waagbo/picogus-tht/hw-tht-v1.3/docs/figures/groundloop.png

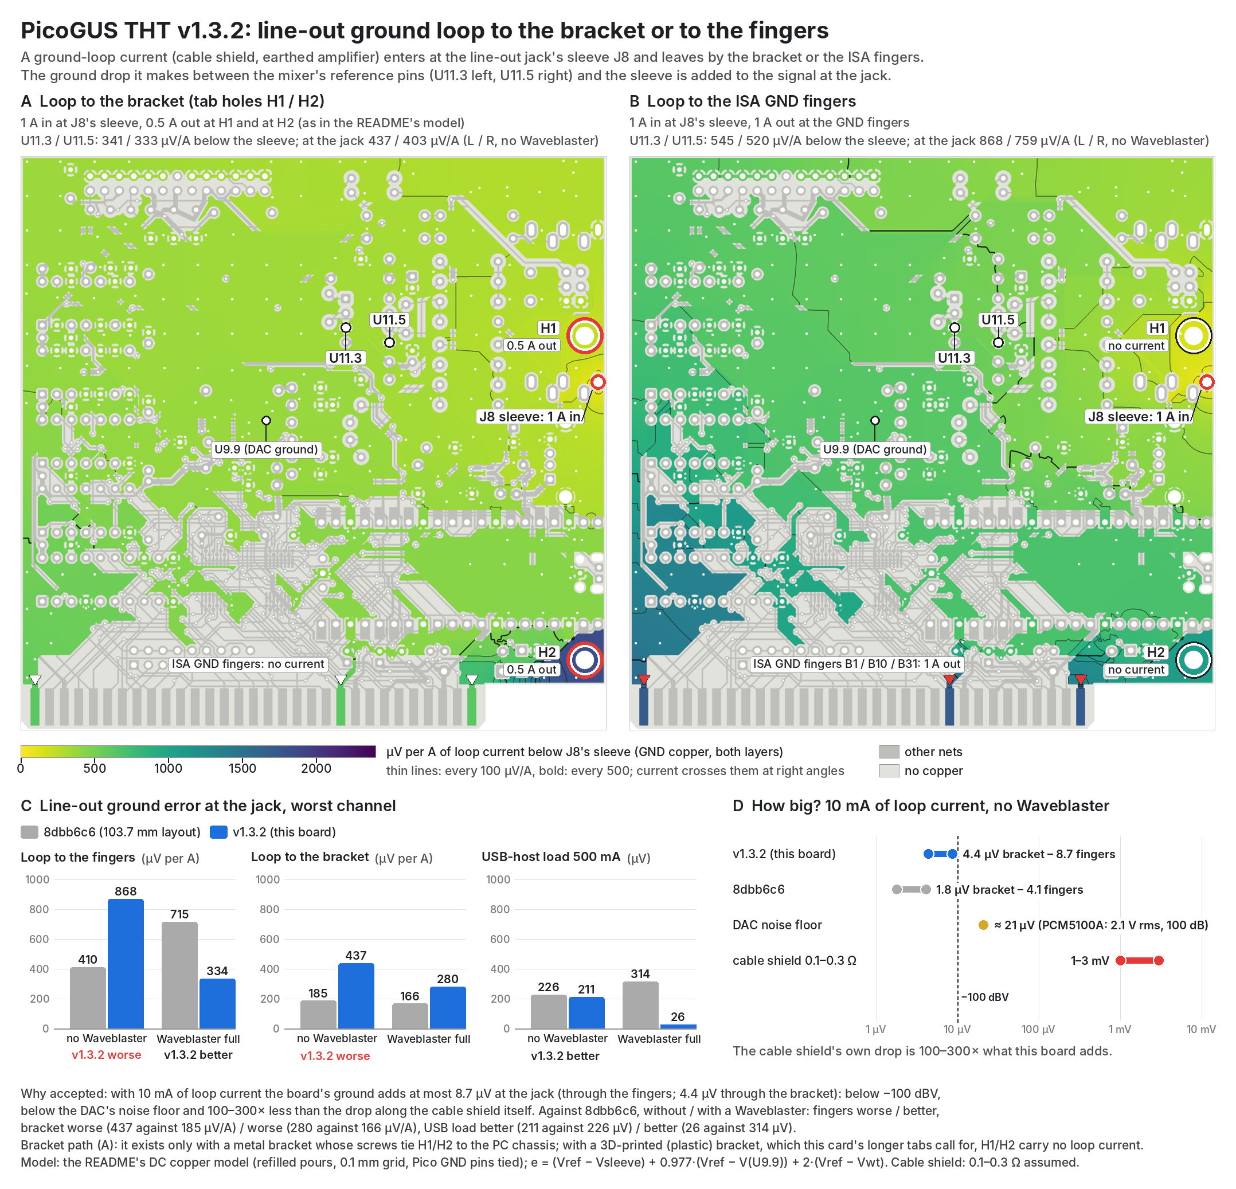
hw-tht-v1.3/docs/figures/groundloop.png
