waagbo/picogus-tht/hw-tht-v1.3/docs/figures/i2s-around-dac.png

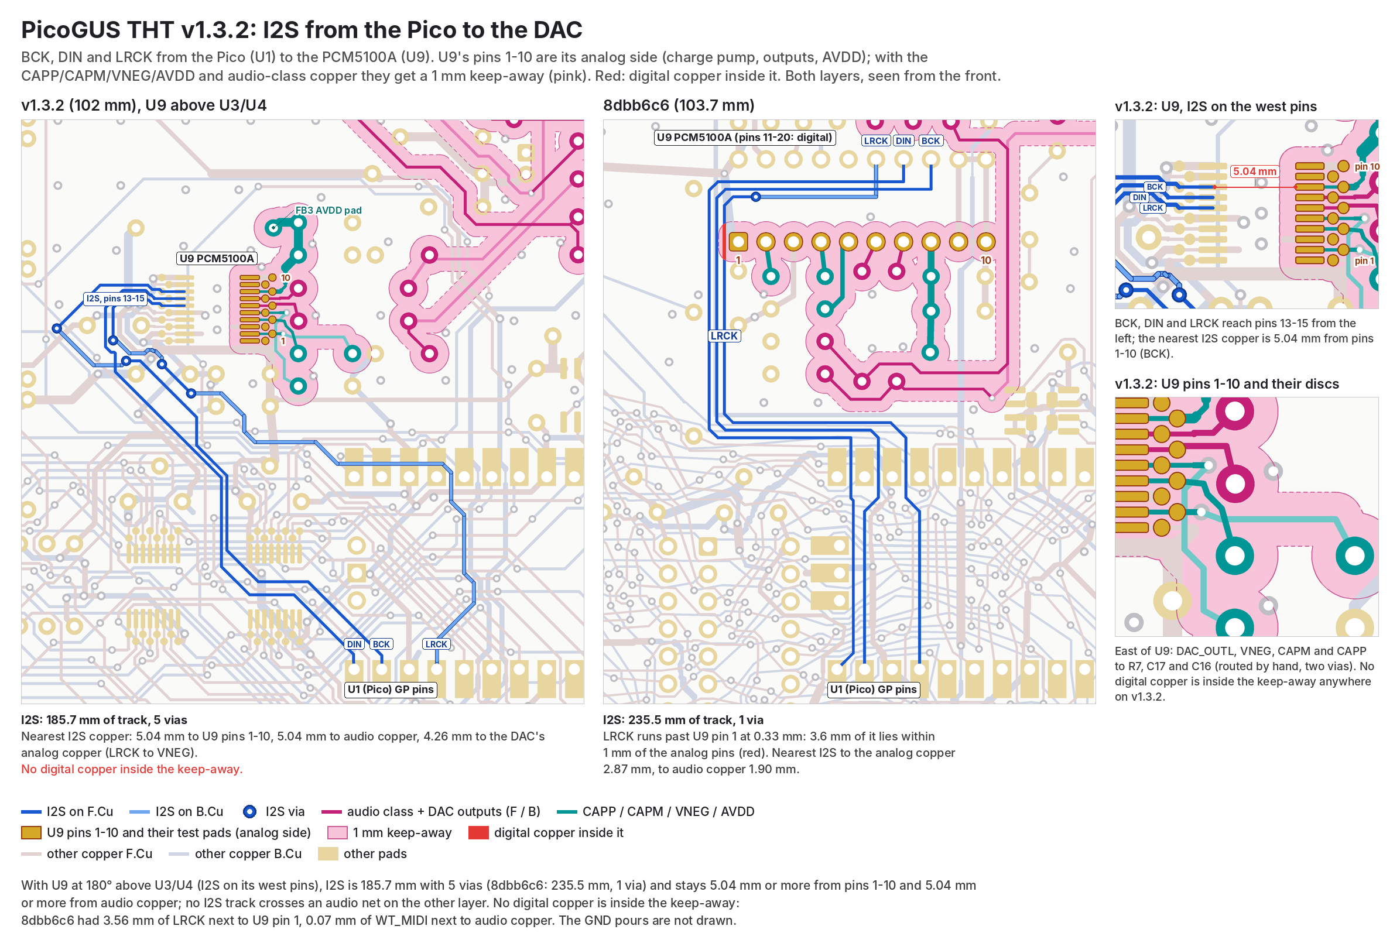
hw-tht-v1.3/docs/figures/i2s-around-dac.png
