waagbo/picogus-tht/hw-tht-v1.3/docs/figures/placement-options.png

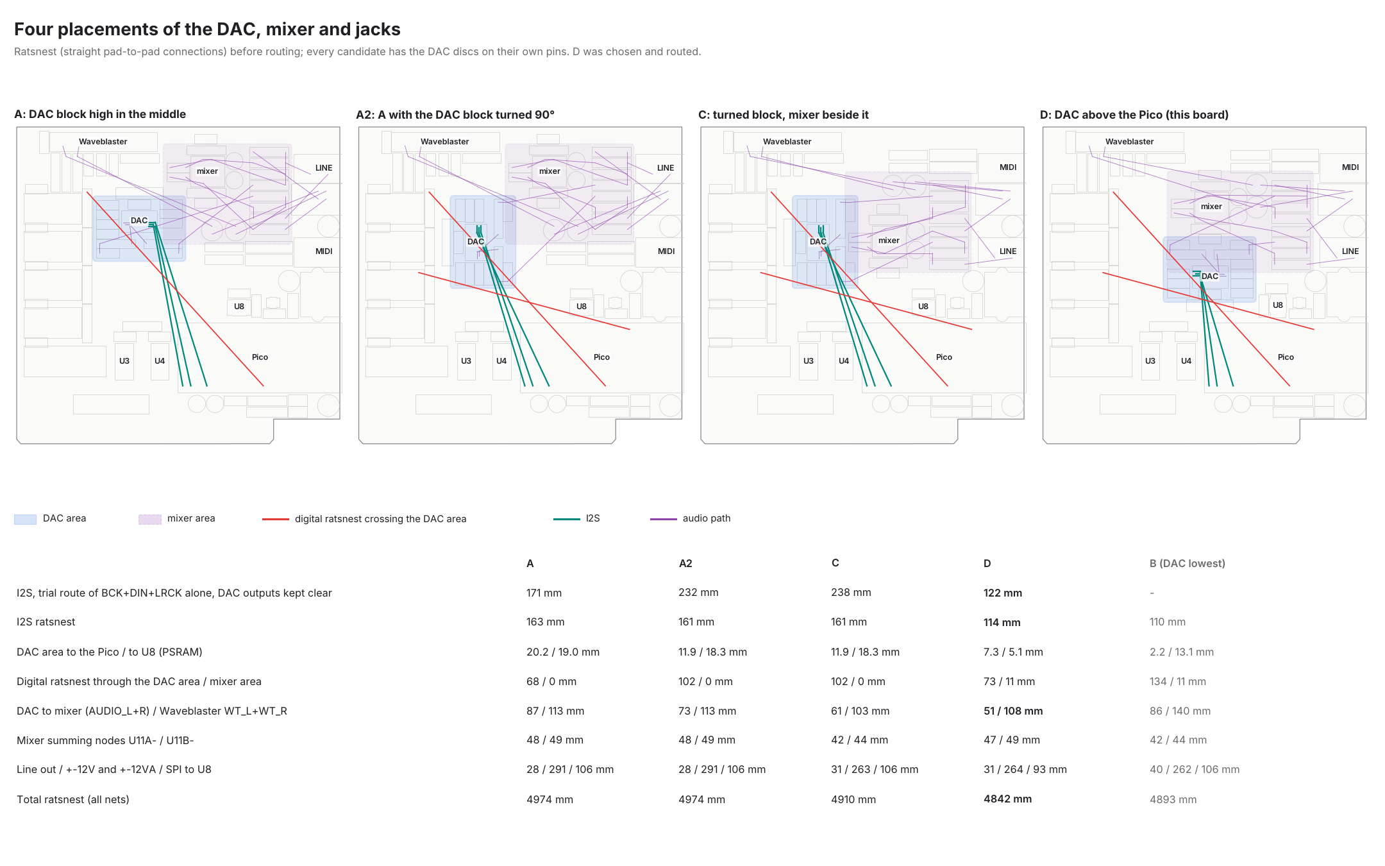
hw-tht-v1.3/docs/figures/placement-options.png
