waagbo/picogus-tht/hw-tht-v1.3/docs/renders/PicoGUS-THT-v1.3.2-red-back.jpg

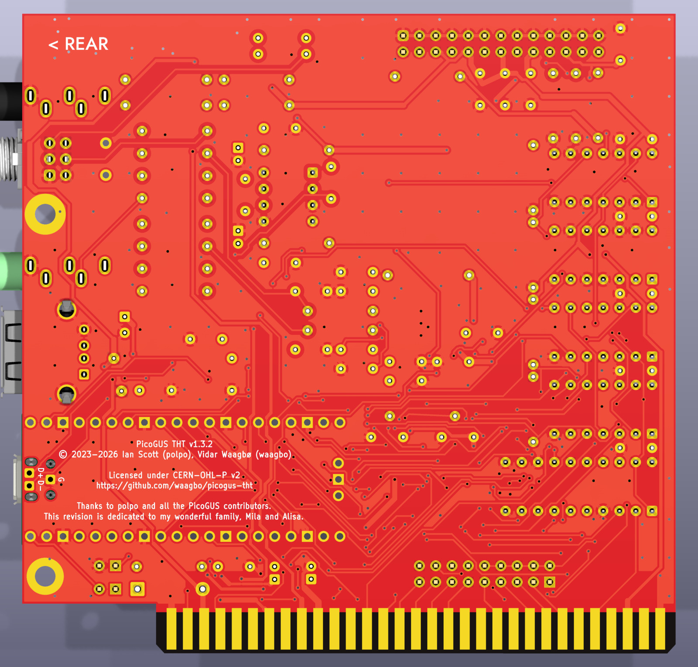
hw-tht-v1.3/docs/renders/PicoGUS-THT-v1.3.2-red-back.jpg
