waagbo/picogus-tht/hw-tht-v1.3/docs/BOM-THT-mouser.csv

Quantity | Manufacturer Part Number | Manufacturer | Customer Part Number | Description
1 | SC0915 | Raspberry Pi | U1 | Raspberry Pi Pico
1 | SN74AHC244N | Texas Instruments | U2 | 74AHC244
2 | SN74CB3T3257PWR | Texas Instruments | U3,U4 | SN74CB3T3257
1 | SN74AHC14N | Texas Instruments | U5 | 74AHC14
2 | SN74AHC00N | Texas Instruments | U6,U7 | 74AHC00
1 | APS6404L-3SQR-SN | AP Memory | U8 | APS6404L-3SQR-SN
1 | PCM5100APWR | Texas Instruments | U9 | PCM5100A
1 | SN74AHCT126N | Texas Instruments | U10 | 74AHCT126
1 | 1N5819RLG | onsemi | D1 | 1N5819
2 | RNMF14FTC220R | Stackpole | R3,R4 | 220R
2 | RNMF14FTC470R | Stackpole | R7,R8 | 470R
1 | MFR-25FBF52-1K | Yageo | R1 | 1k
5 | MFR-25FBF52-10K | Yageo | R9,R12,R13,R16,R17 | 10k
4 | MFR-25FBF52-20K | Yageo | R10,R11,R19,R20 | 20k
3 | MFR-25FBF52-15K | Yageo | R2,R5,R6 | 15k
20 | RDER71H104K0M1H03A | Murata | 0.1uF x20 | 0.1uF
1 | RDER71H105K2M1H03A | Murata | C10 | 1uF
2 | FG24X7R1H225KRT06 | TDK | C16,C17 | 2.2uF
2 | RCER71H106MWK1H03B | Murata | C15,C24 | 10uF
2 | FG28C0G1H222JNT06 | TDK | C19,C20 | 2.2nF C0G
4 | 35YXJ47M5X11 | Rubycon | C1,C2,C32,C33 | 47uF
2 | ECE-A1HN100U | Panasonic | C22,C23 | 10uF bipolar
3 | 2743002112 | Fair-Rite | FB1,FB2,FB3 | Ferrite bead
1 | PTD902-2015F-A103 | Bourns | RV1 | 10k dual log
1 | 77313-118-18LF | Amphenol ICC (FCI) | J1 | 2x9 header, gold
4 | M7582-05 | Harwin | J1,J7 shunts | 2.54mm jumper shunt
2 | 77311-118-02LF | Amphenol ICC (FCI) | J6,J7 | 1x2 header, gold
1 | SJ1-3535NG | Same Sky (CUI) | J5 | SJ1-3535NG (black)
1 | SJ1-3535NG-GR | Same Sky (CUI) | J8 | SJ1-3535NG-GR (green)
1 | 77313-118-26LF | Amphenol ICC (FCI) | J9 | Waveblaster 2x13 male, gold
1 | 0676430910 | Molex | J11 | USB-A receptacle
1 | MF-R050 | Bourns | F1 | 0.5A PTC
1 | 16ZLH220MEFC6.3X11 | Rubycon | C34 | 220uF
1 | NE5532P | Texas Instruments | U11 | NE5532
3 | MFR-25FBF52-100K | Yageo | R14,R15,R18 | 100k
2 | MFR-25FBF52-10R | Yageo | R23,R24 | 10R
2 | MFR-25FBF52-100R | Yageo | R21,R22 | 100R
2 | K470J15C0GF5TH5 | Vishay | C30,C31 | 47pF C0G
2 | PPTC201LFBN-RC | Sullins | U1 sockets (optional) | 1x20 female header x2
4 | ICM-314-1-GT-HT | Adam Tech | U5,U6,U7,U10 (opt.) | DIP-14 socket
1 | SA203000 | On Shore Technology | U2 socket (optional) | DIP-20 socket
1 | SA083000 | On Shore Technology | U11 socket (optional) | DIP-8 socket
1 | USBLC6-2SC6 | STMicroelectronics | U12 (optional) | USBLC6-2SC6
