waagbo/picogus-tht/hw-tht-v1.3/docs/BOM-THT-lcsc.csv

Quantity | LCSC Part Number | Manufacturer Part Number | Customer Part Number
1 | C1548228 | SN74AHC244N | PicoGUS-THT-1.3.2: U2
2 | C544573 | SN74CB3T3257PWR | PicoGUS-THT-1.3.2: U3,U4
1 | C2879116 | SN74AHC14N | PicoGUS-THT-1.3.2: U5
2 | C2879122 | SN74AHC00N | PicoGUS-THT-1.3.2: U6,U7
1 | C5333729 | APS6404L-3SQR-SN | PicoGUS-THT-1.3.2: U8
1 | C131154 | PCM5100APWR | PicoGUS-THT-1.3.2: U9
1 | C1548378 | SN74AHCT126N | PicoGUS-THT-1.3.2: U10
1 | C88393 | 1N5819RLG | PicoGUS-THT-1.3.2: D1
2 | C3537012 | MFR-25FBF52-220R | PicoGUS-THT-1.3.2: R3,R4
2 | C58592 | MFR0W4F4700A50 | PicoGUS-THT-1.3.2: R7,R8
1 | C57435 | MFR0W4F1001A50 | PicoGUS-THT-1.3.2: R1
5 | C1519255 | MFR-25FBF52-10K | PicoGUS-THT-1.3.2: R9,R12,R13,R16,R17
4 | C1364283 | MFR-25FBF52-20K | PicoGUS-THT-1.3.2: R10,R11,R19,R20
3 | C3556390 | MFR-25FBF52-15K | PicoGUS-THT-1.3.2: R2,R5,R6
20 | C527620 | RDER71H104K0M1H03A | PicoGUS-THT-1.3.2: C3-9,11-14,18,21,25-29,35,36
1 | C1620132 | RDER71H105K2M1H03A | PicoGUS-THT-1.3.2: C10
2 | C1623182 | FG24X7R1H225KRT06 | PicoGUS-THT-1.3.2: C16,C17
2 | C3690252 | RCER71H106MWM1H03A | PicoGUS-THT-1.3.2: C15,C24
2 | C22391154 | CD1H222JC9PECHD000 | PicoGUS-THT-1.3.2: C19,C20
4 | C88761 | 35YXJ47M5X11 | PicoGUS-THT-1.3.2: C1,C2,C32,C33
2 | C6029955 | ECE-A1HN100UB | PicoGUS-THT-1.3.2: C22,C23
3 | C192455 | RH3.5x0.8x9P52E | PicoGUS-THT-1.3.2: FB1,FB2,FB3
1 | C444934 | RK09712200MC | PicoGUS-THT-1.3.2: RV1
1 | C492426 | PZ254V-12-18P | PicoGUS-THT-1.3.2: J1
4 | C168674 | 68786-102LF | PicoGUS-THT-1.3.2: J1,J7 shunts
2 | C599036 | 77311-118-02LF | PicoGUS-THT-1.3.2: J6,J7
1 | C2884945 | PJ-325C5-B | PicoGUS-THT-1.3.2: J5
1 | C692438 | PJ-325C5-G | PicoGUS-THT-1.3.2: J8
1 | C2894974 | PZ254-2-13-Z-8.5 | PicoGUS-THT-1.3.2: J9
1 | C2798029 | 0676430910 | PicoGUS-THT-1.3.2: J11
1 | C208476 | MF-R050 | PicoGUS-THT-1.3.2: F1
1 | C338177 | 16ZLH220MEFC6.3X11 | PicoGUS-THT-1.3.2: C34
1 | C5326 | NE5532P | PicoGUS-THT-1.3.2: U11
3 | C58597 | MFR0W4F1003A50 | PicoGUS-THT-1.3.2: R14,R15,R18
2 | C119282 | MF1/4W-10R 1% | PicoGUS-THT-1.3.2: R23,R24
2 | C57438 | MFR0W4F1000A50 | PicoGUS-THT-1.3.2: R21,R22
2 | C3690607 | K470J15C0GF5TH5 | PicoGUS-THT-1.3.2: C30,C31
2 | C2897383 | PM254-1-20-Z-8.5 | PicoGUS-THT-1.3.2: U1 sockets (optional)
4 | C72126 | DS1001-01-14BT1NSF6X-JKB | PicoGUS-THT-1.3.2: U5,U6,U7,U10 sockets (opt.)
1 | C72127 | DS1001-01-20BT1NSF6S-JKB | PicoGUS-THT-1.3.2: U2 socket (optional)
1 | C72129 | DS1001-01-08BT1NSF6X-JKB | PicoGUS-THT-1.3.2: U11 socket (optional)
1 | C7519 | USBLC6-2SC6 | PicoGUS-THT-1.3.2: U12 (optional)
