waagbo/picogus-tht/hw-common/parts/CUI_DEVICES_SJ1-3535NG-black.step

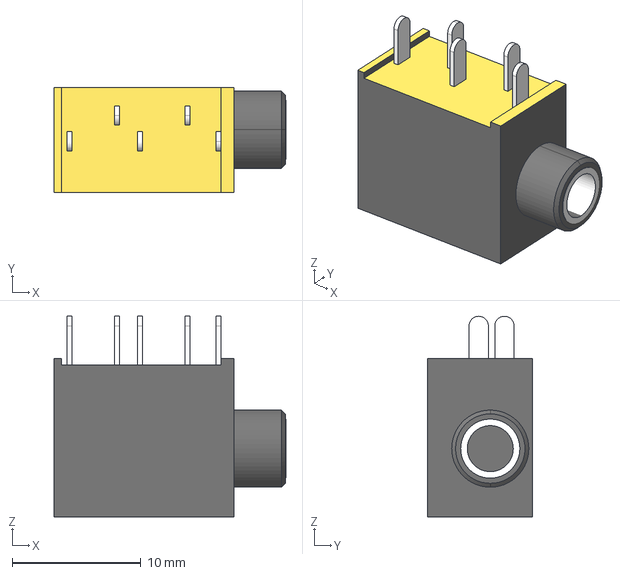
[picture p16: CAD file, 2026-11-07]
hw-common/parts/CUI_DEVICES_SJ1-3535NG-black.step
18.1 x 8.20 x 15.6 mm
