waagbo/picogus-tht/hw-tht-v1.3/PicoGUS-THT-schematic.pdf

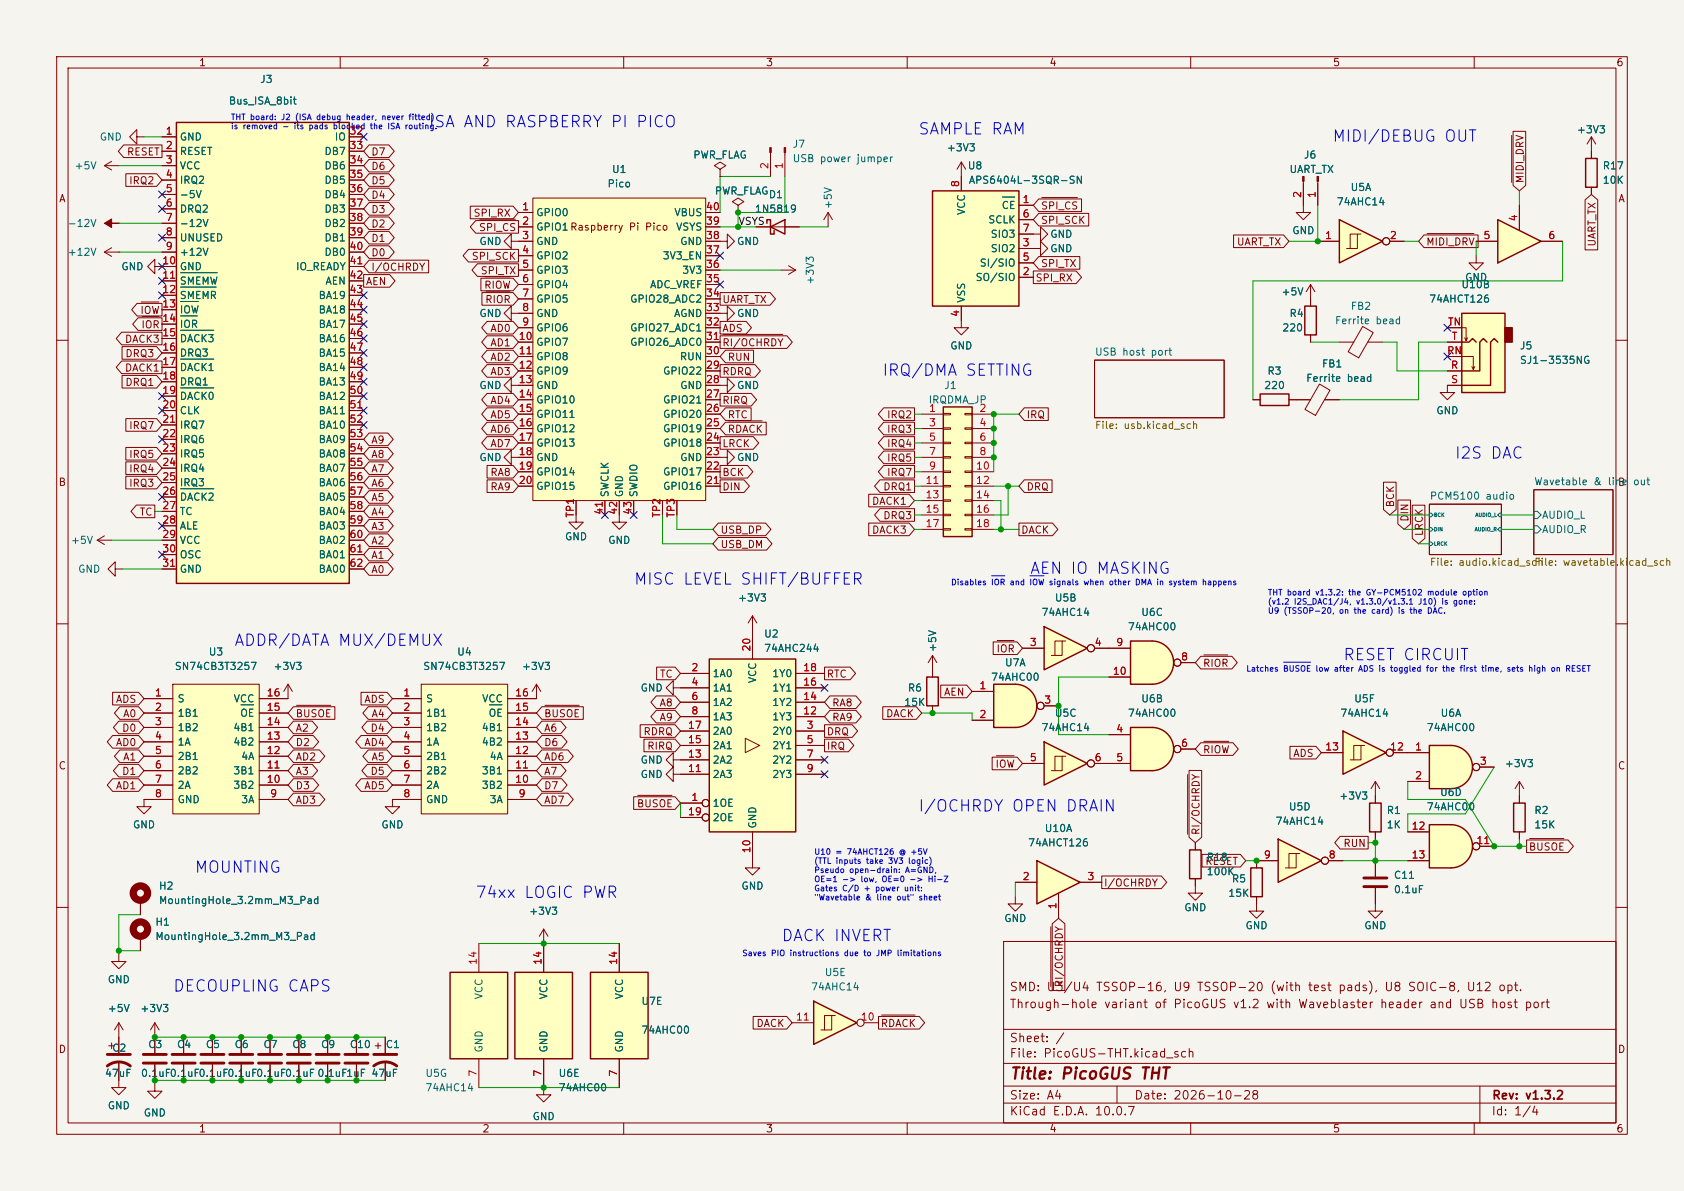
[picture p17: page 1]

THT board: J2 (ISA debug header, never fitted)

ISA AND RASPBERRY PI PICO

USB host port File: usb.kicad_sch

(TTL inputs take 3V3 logic) Pseudo open-drain: A=GND, OE=1 -> low, OE=0 -> Hi-Z Gates C/D + power unit: "Wavetable & line out" sheet Disables IOR and IOW signals when other DMA in system happens 74xx LOGIC PWR

MISC LEVEL SHIFT/BUFFER

(v1.2 I2S_DAC1/J4, v1.3.0/v1.3.1 J10) is gone: U9 (TSSOP-20, on the card) is the DAC. RESET CIRCUIT ADDR/DATA MUX/DEMUX

THT board v1.3.2: the GY-PCM5102 module option

Latches BUSOE low after ADS is toggled for the first time, sets high on RESET

Saves PIO instructions due to JMP limitations

SMD: U3/U4 TSSOP-16, U9 TSSOP-20 (with test pads), U8 SOIC-8, U12 opt.
Through-hole variant of PicoGUS v1.2 with Waveblaster header and USB host port

Size: A4 | Rev: v1.3.2
KiCad E.D.A. 10.0.7 | Id: 1/4

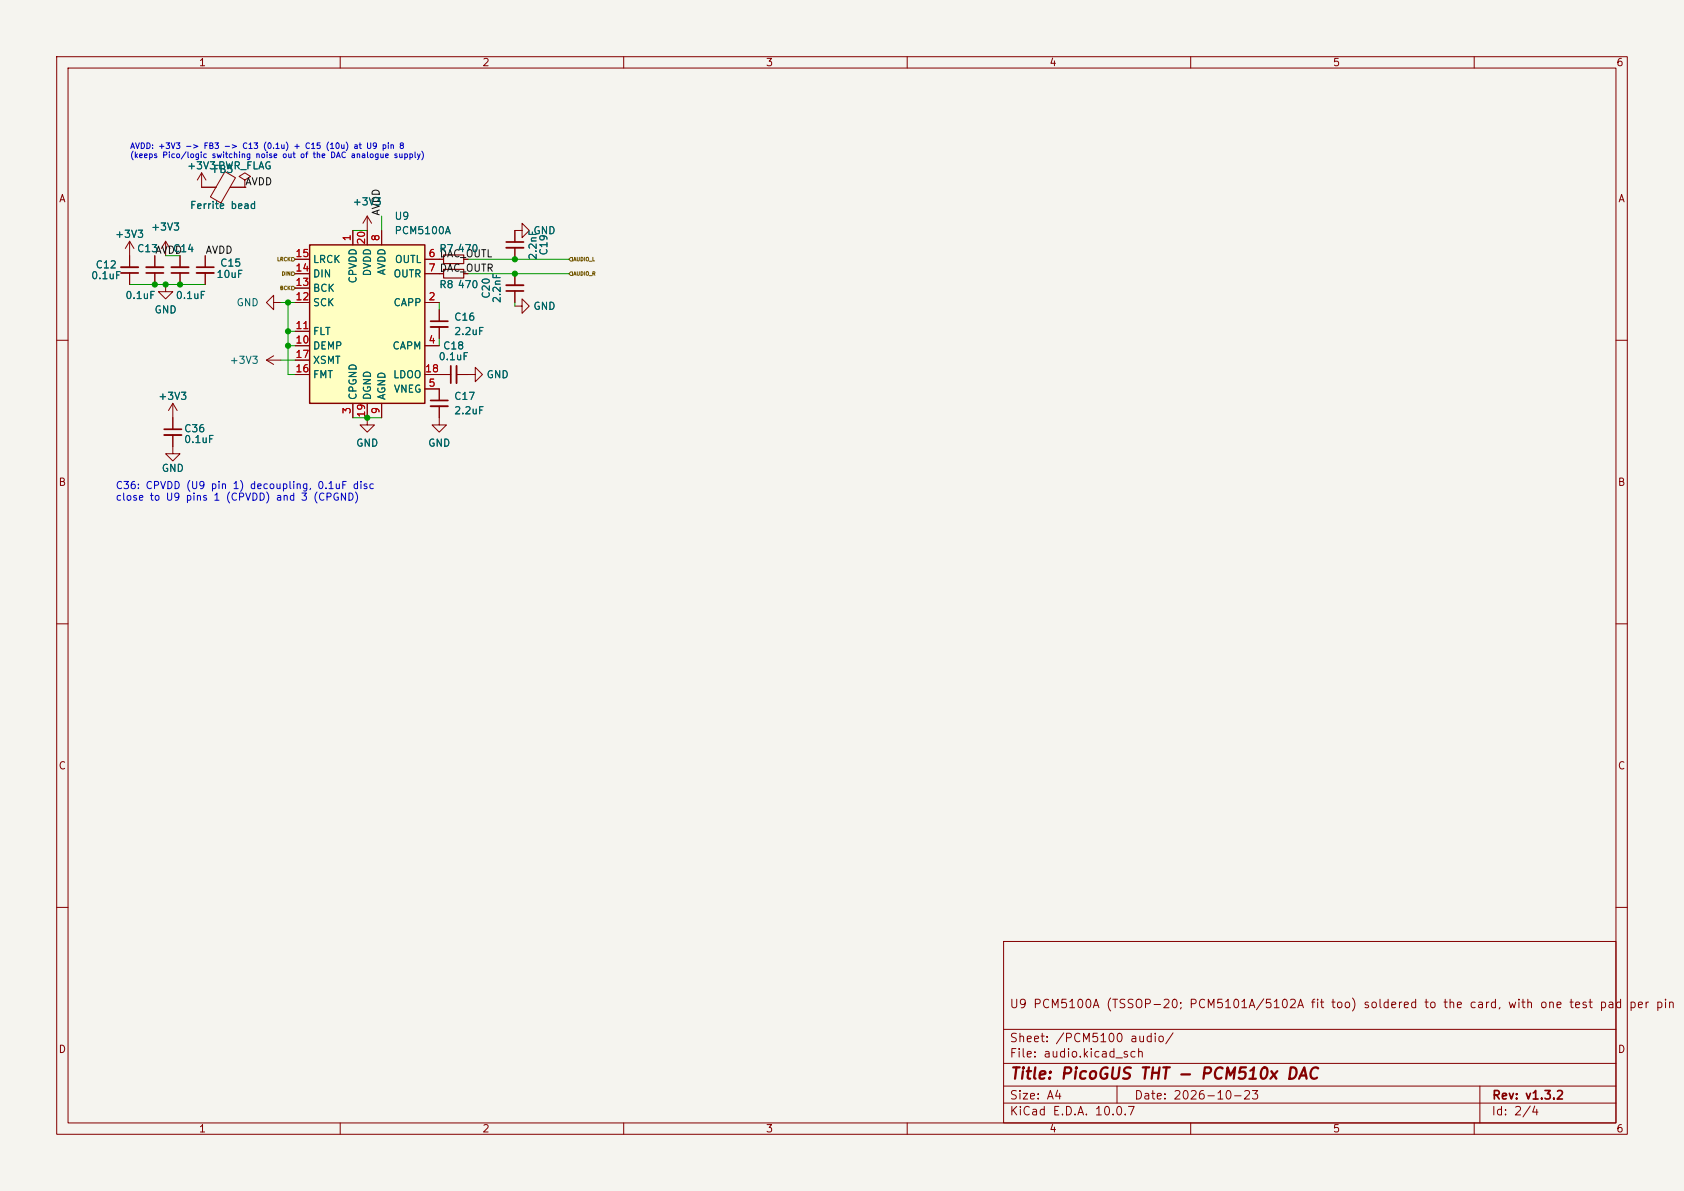
[picture p18: page 2]

AVDD: +3V3 -> FB3 -> C13 (0.1u) + C15 (10u) at U9 pin 8
(keeps Pico/logic switching noise out of the DAC analogue supply) C36: CPVDD (U9 pin 1) decoupling, 0.1uF disc
LDOO 18 DGND 19 DVDD 20 GND

close to U9 pins 1 (CPVDD) and 3 (CPGND) C15

SCK 12 BCK 13 DIN 14 LRCK 15
AUDIO_L DIN

U9 PCM5100A (TSSOP-20; PCM5101A/5102A fit too) soldered to the card, with one test pad per pin

Sheet: /PCM5100 audio/
File: audio.kicad_sch
Title: PicoGUS THT - PCM510x DAC

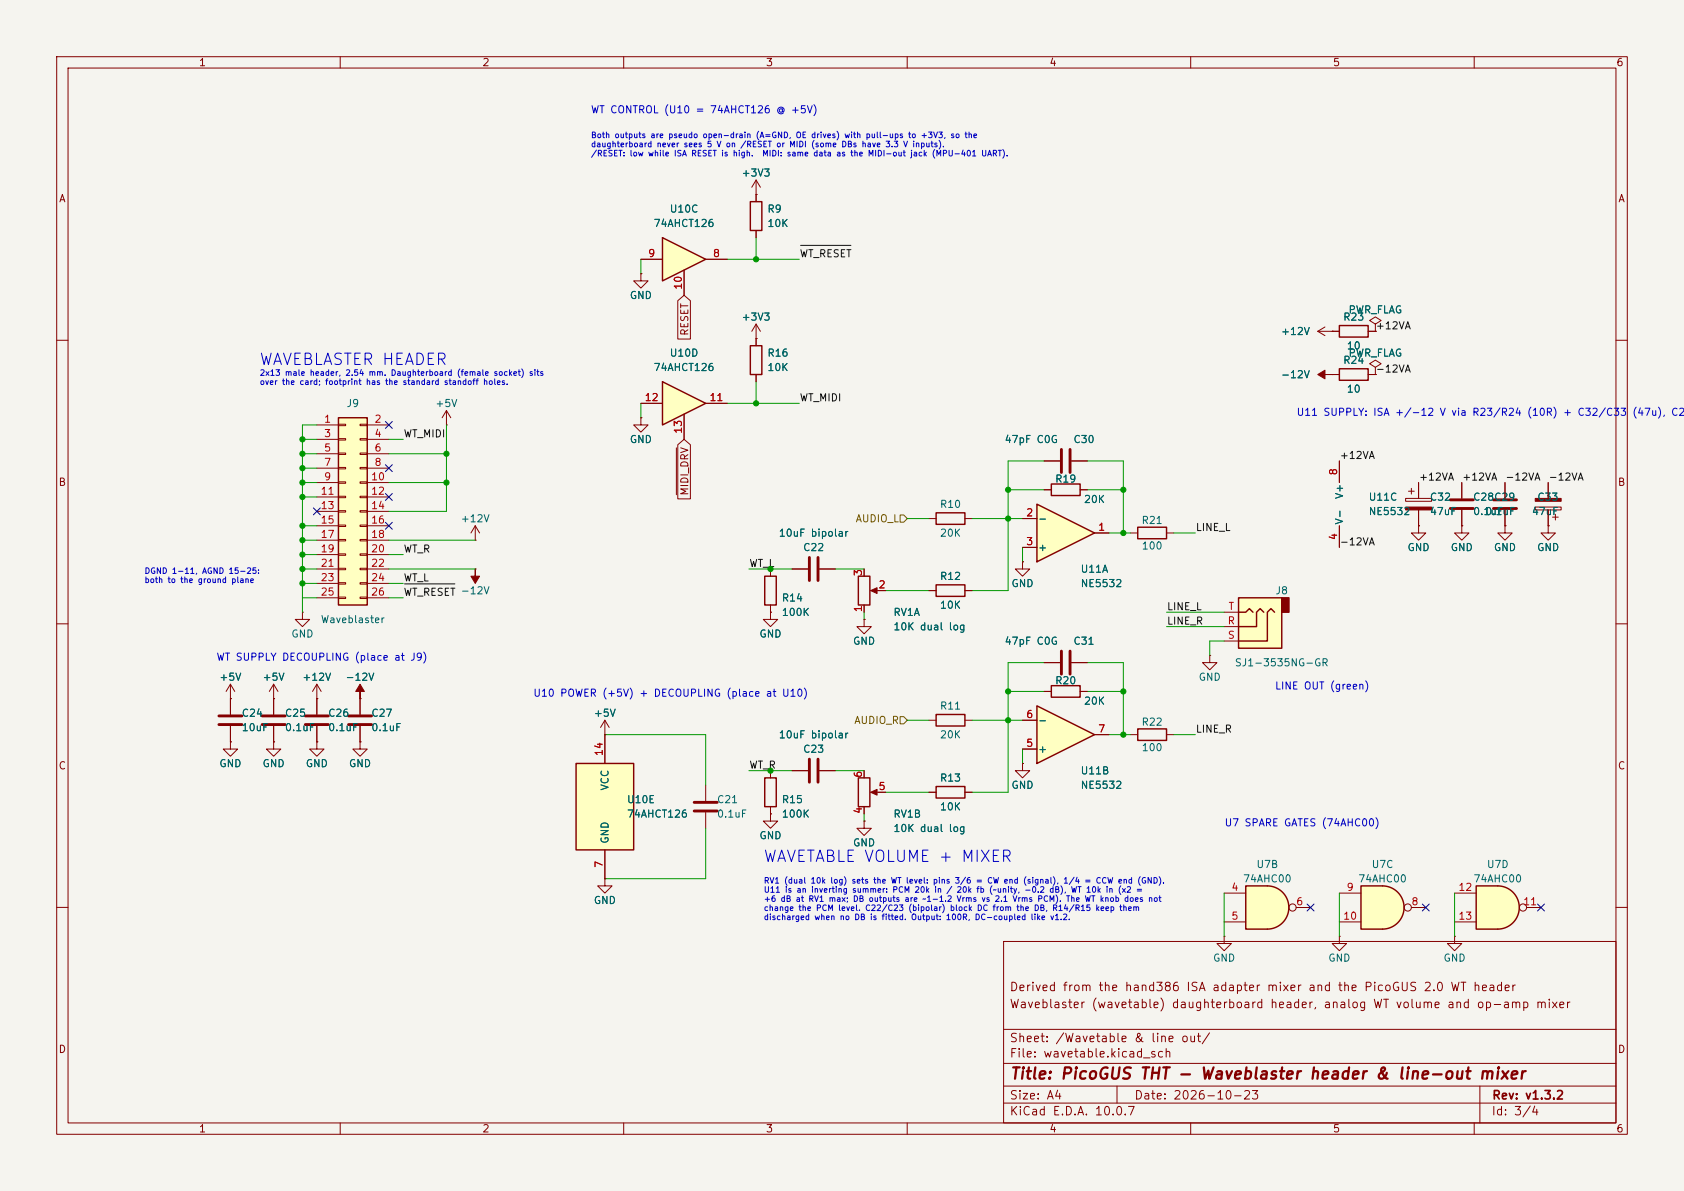
[picture p19: page 3]

RV1 (dual 10k log) sets the WT level: pins 3/6 = CW end (signal), 1/4 = CCW end (GND). U11 is an inverting summer: PCM 20k in / 20k fb (~unity, -0.2 dB), WT 10k in (x2 =

+6 dB at RV1 max; DB outputs are ~1-1.2 Vrms vs 2.1 Vrms PCM). The WT knob does not change the PCM level. C22/C23 (bipolar) block DC from the DB, R14/R15 keep them

discharged when no DB is fitted. Output: 100R, DC-coupled like v1.2.

Waveblaster (wavetable) daughterboard header, analog WT volume and op-amp mixer

Sheet: /Wavetable & line out/
File: wavetable.kicad_sch
Title: PicoGUS THT - Waveblaster header & line-out mixer

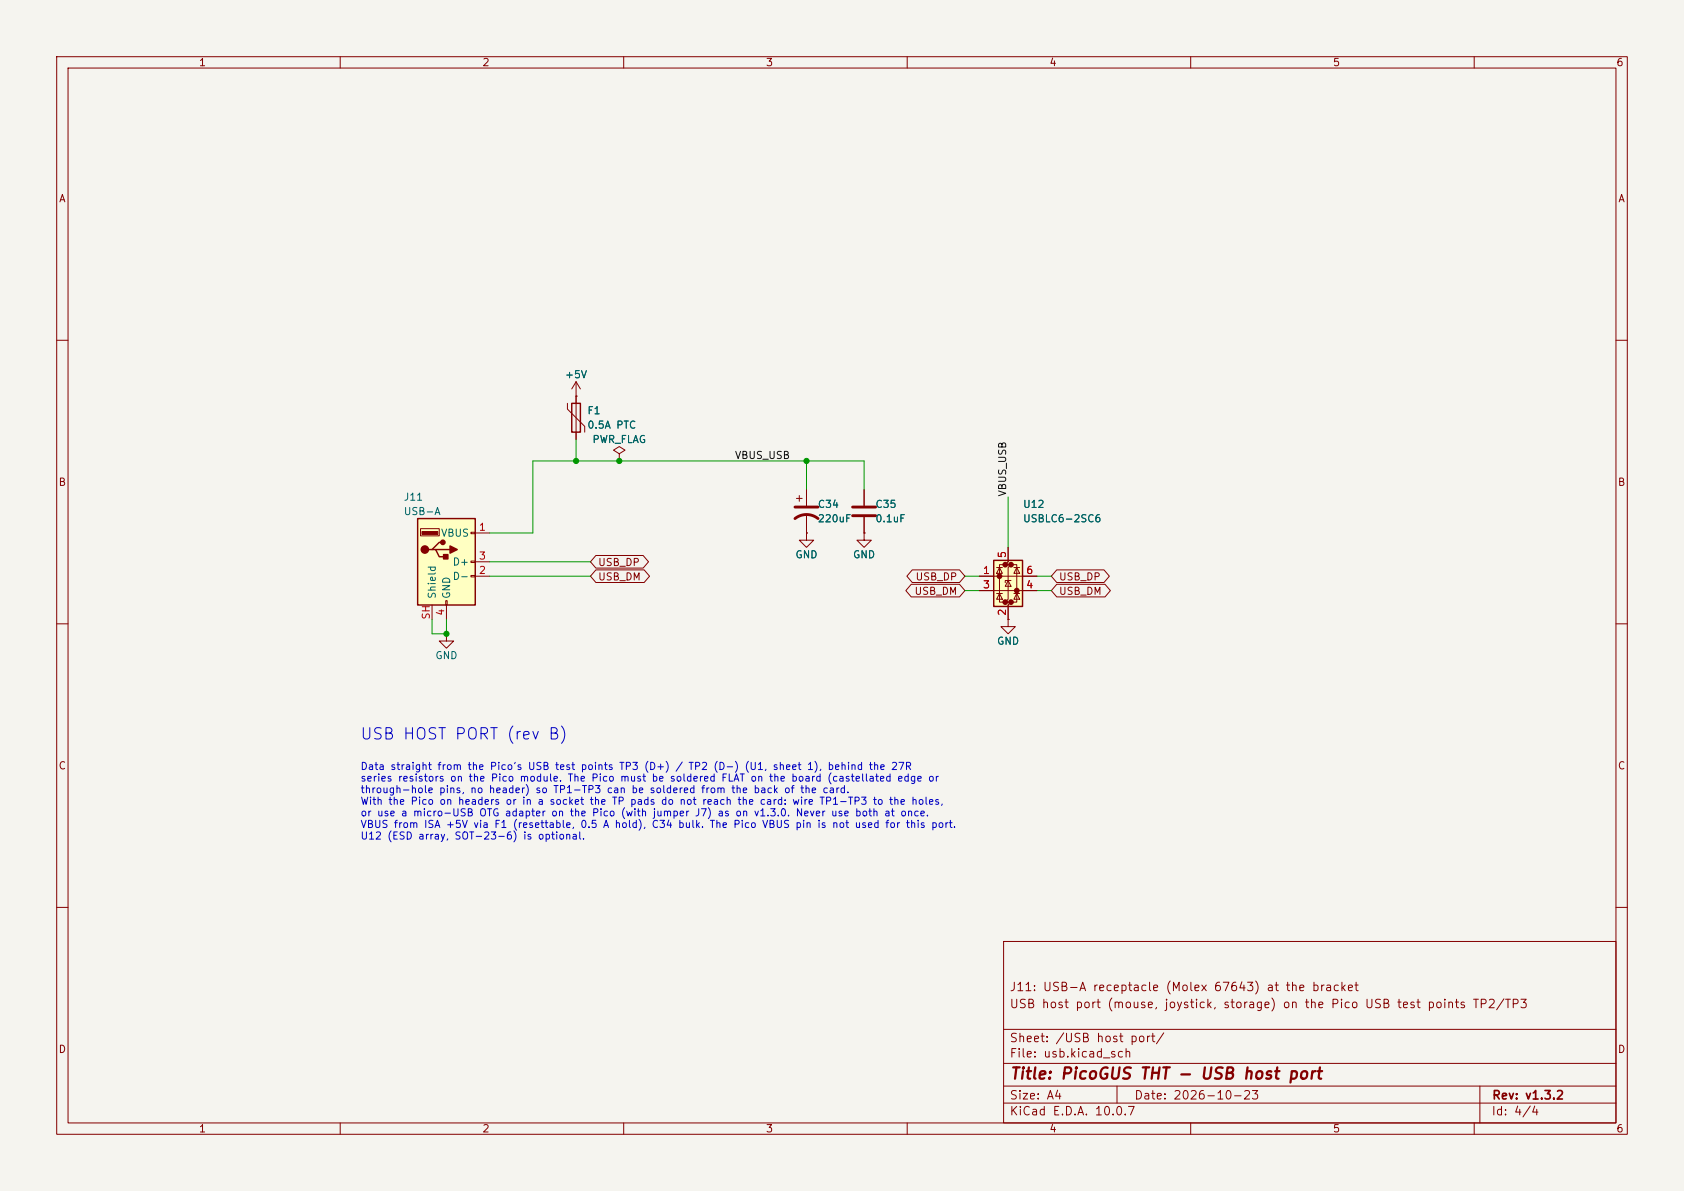
[picture p20: page 4]

through-hole pins, no header) so TP1-TP3 can be soldered from the back of the card. With the Pico on headers or in a socket the TP pads do not reach the card: wire TP1-TP3 to the holes, or use a micro-USB OTG adapter on the Pico (with jumper J7) as on v1.3.0. Never use both at once. VBUS from ISA +5V via F1 (resettable, 0.5 A hold), C34 bulk. The Pico VBUS pin is not used for this port. U12 (ESD array, SOT-23-6) is optional. +5V

J11: USB-A receptacle (Molex 67643) at the bracket GND

USB HOST PORT (rev B)

Data straight from the Pico's USB test points TP3 (D+) / TP2 (D-) (U1, sheet 1), behind the 27R
series resistors on the Pico module. The Pico must be soldered FLAT on the board (castellated edge or

USB host port (mouse, joystick, storage) on the Pico USB test points TP2/TP3

Sheet: /USB host port/
File: usb.kicad_sch
Title: PicoGUS THT - USB host port
