waagbo/picogus-tht/hw-ne2k/PicoGUS-NE2K-schematic.pdf

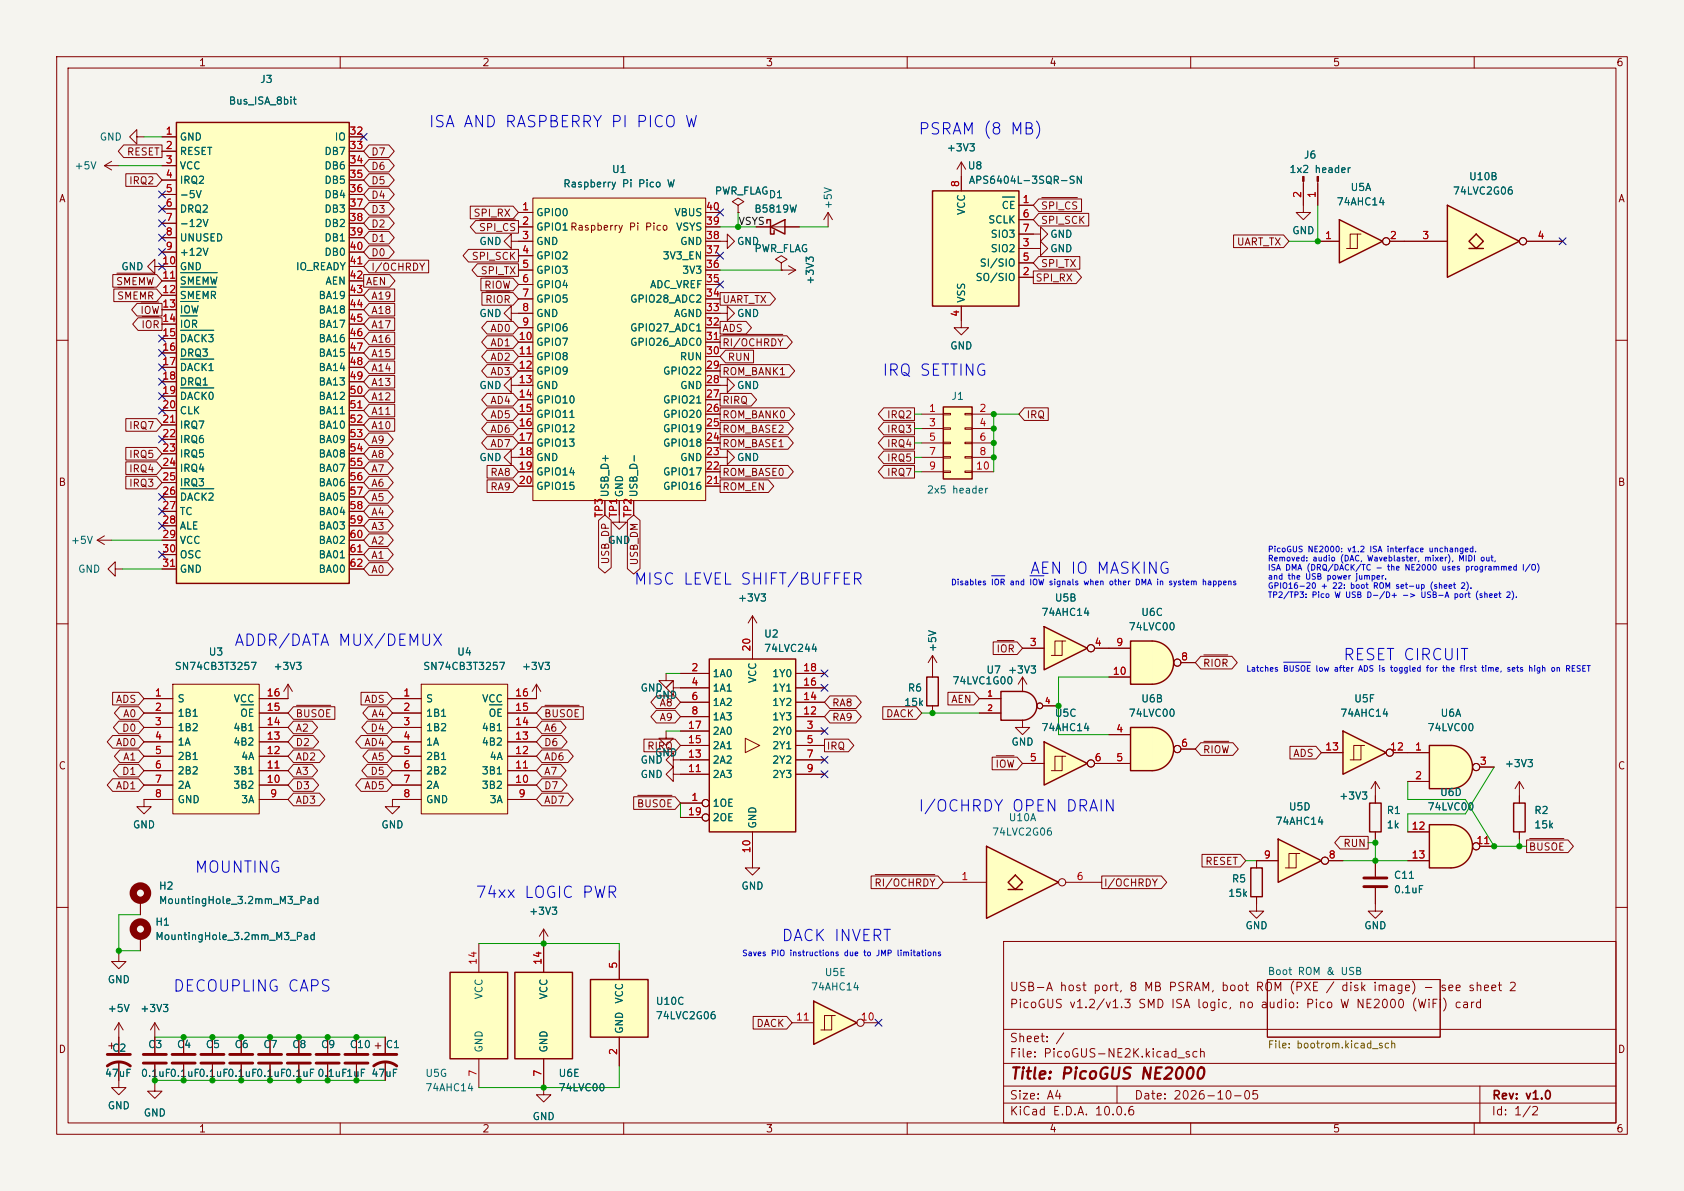
[picture p21: page 1]

ISA AND RASPBERRY PI PICO W

PicoGUS NE2000: v1.2 ISA interface unchanged. Removed: audio (DAC, Waveblaster, mixer), MIDI out,

Disables IOR and IOW signals when other DMA in system happens AEN IO MASKING MISC LEVEL SHIFT/BUFFER

ISA DMA (DRQ/DACK/TC - the NE2000 uses programmed I/O) and the USB power jumper. GPIO16-20 + 22: boot ROM set-up (sheet 2). TP2/TP3: Pico W USB D-/D+ -> USB-A port (sheet 2).

ADDR/DATA MUX/DEMUX
Latches BUSOE low after ADS is toggled for the first time, sets high on RESET MOUNTING

Saves PIO instructions due to JMP limitations

PicoGUS v1.2/v1.3 SMD ISA logic, no audio: Pico W NE2000 (WiFi) card

Size: A4 | Rev: v1.0
KiCad E.D.A. 10.0.6 | Id: 1/2

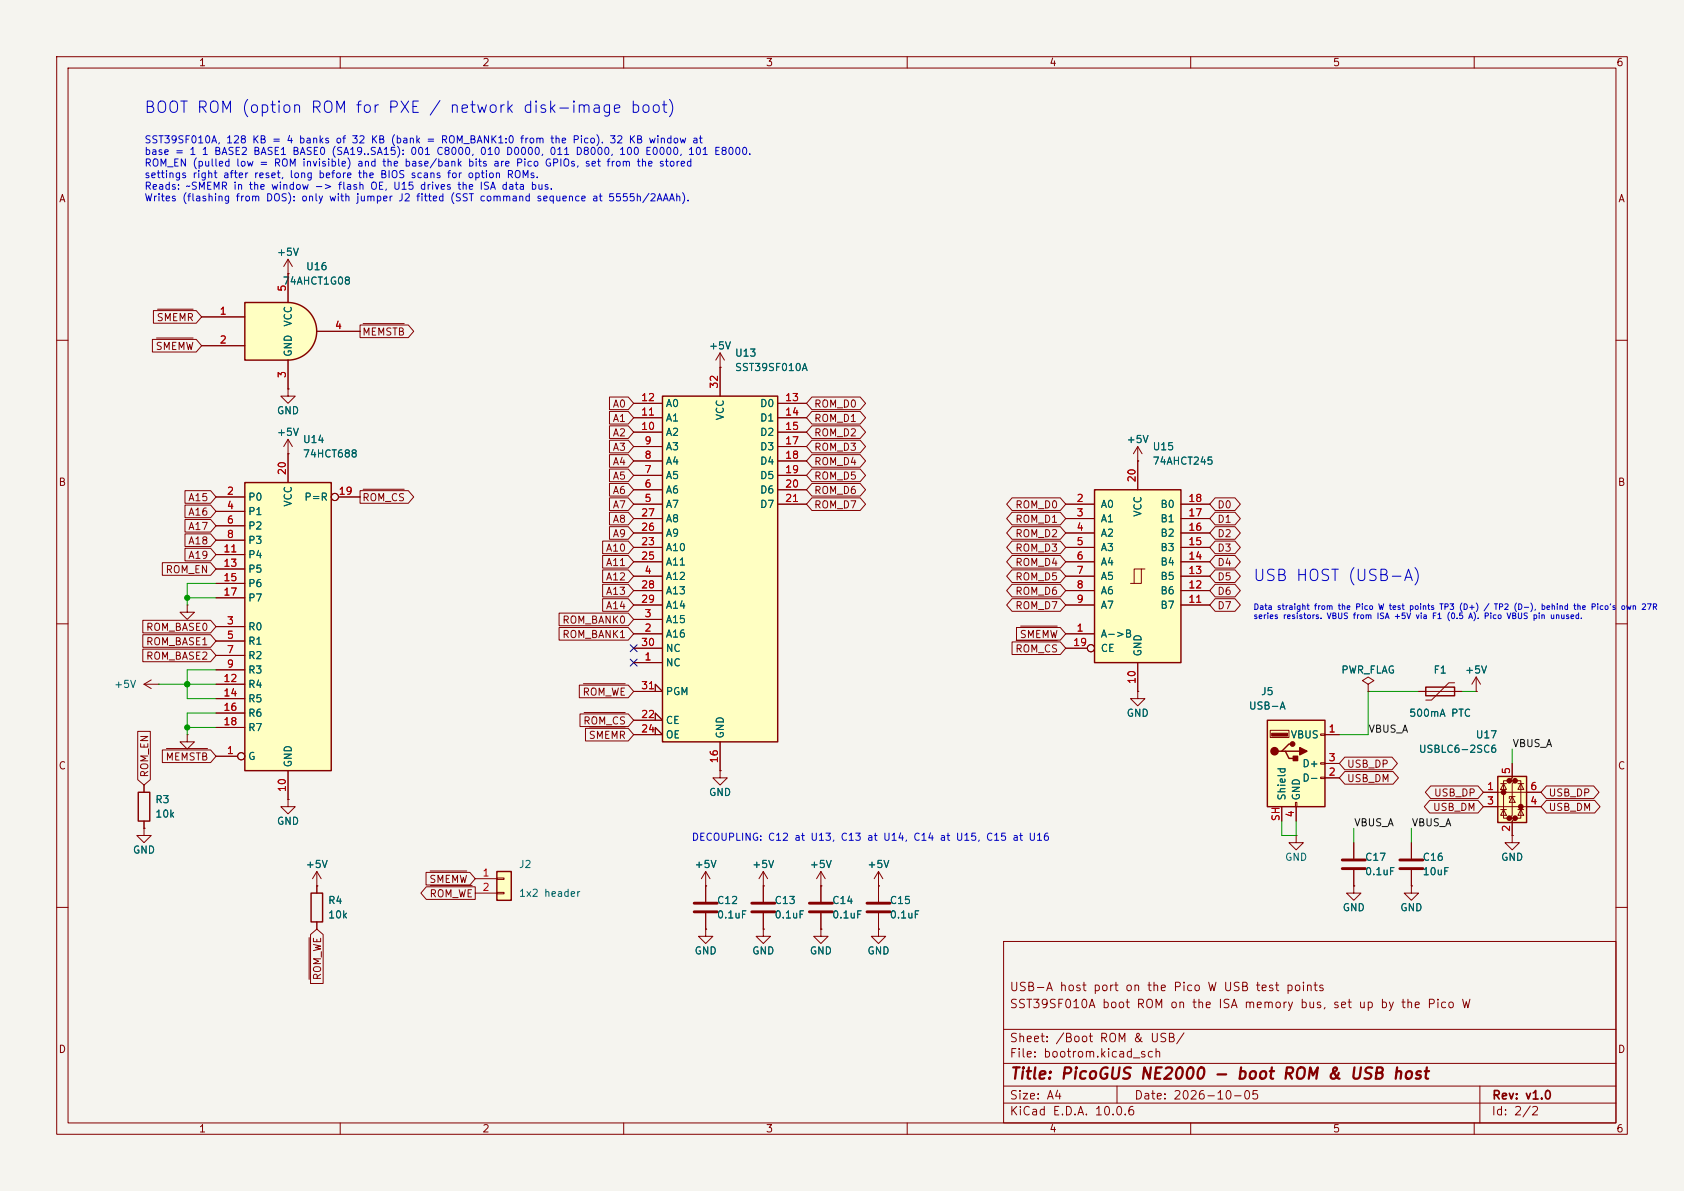
[picture p22: page 2]

series resistors. VBUS from ISA +5V via F1 (0.5 A). Pico VBUS pin unused. SST39SF010A, 128 KB = 4 banks of 32 KB (bank = ROM_BANK1:0 from the Pico). 32 KB window at base = 1 1 BASE2 BASE1 BASE0 (SA19..SA15): 001 C8000, 010 D0000, 011 D8000, 100 E0000, 101 E8000. ROM_EN (pulled low = ROM invisible) and the base/bank bits are Pico GPIOs, set from the stored

settings right after reset, long before the BIOS scans for option ROMs. Reads: ~SMEMR in the window -> flash OE, U15 drives the ISA data bus. Writes (flashing from DOS): only with jumper J2 fitted (SST command sequence at 5555h/2AAAh).

Data straight from the Pico W test points TP3 (D+) / TP2 (D-), behind the Pico's own 27R

USB-A host port on the Pico W USB test points
SST39SF010A boot ROM on the ISA memory bus, set up by the Pico W

Sheet: /Boot ROM & USB/
File: bootrom.kicad_sch
Title: PicoGUS NE2000 - boot ROM & USB host

Size: A4 | Rev: v1.0
KiCad E.D.A. 10.0.6 | Id: 2/2
