waagbo/picogus-tht/hw-smd/PicoGUS-SMD-schematic.pdf

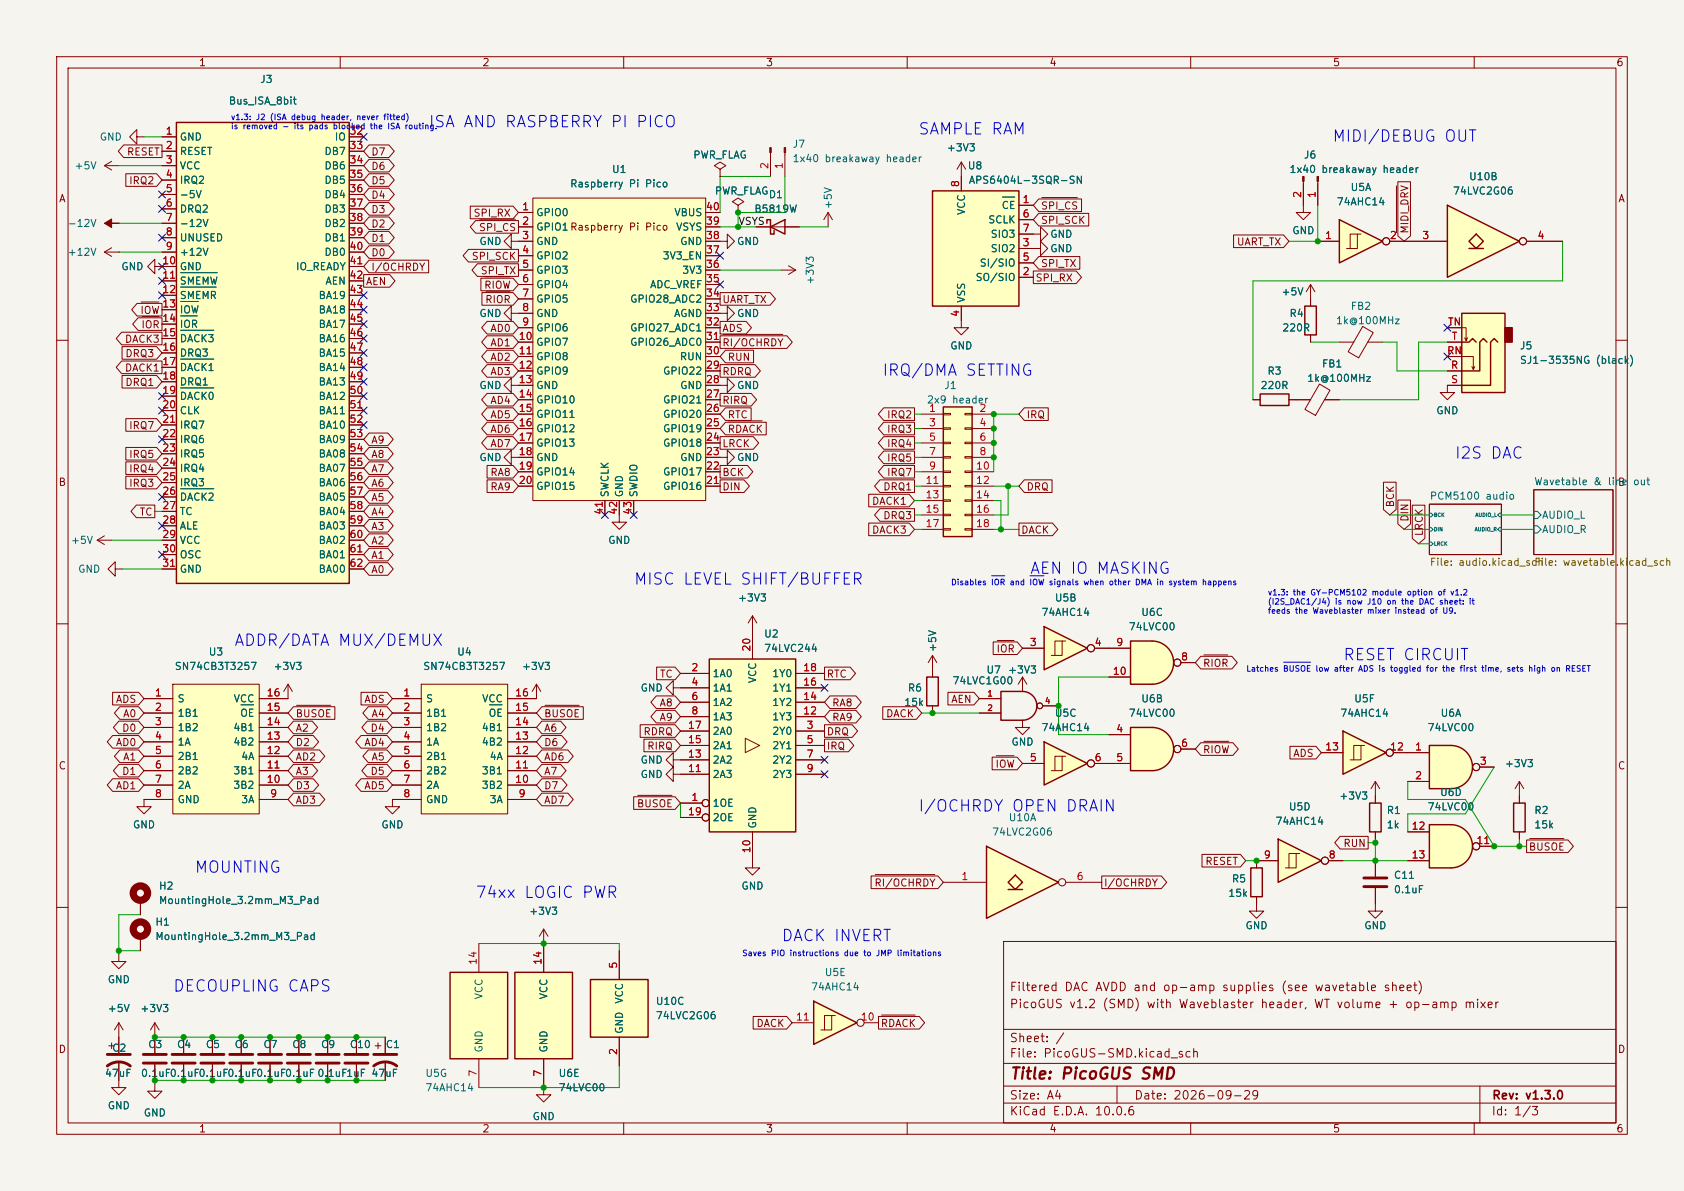
[picture p23: page 1]

v1.3: J2 (ISA debug header, never fitted)

ISA AND RASPBERRY PI PICO

feeds the Waveblaster mixer instead of U9. IRQ/DMA SETTING

AUDIO_L AUDIO_R Wavetable & line out File: wavetable.kicad_sch

Disables IOR and IOW signals when other DMA in system happens MOUNTING

v1.3: the GY-PCM5102 module option of v1.2
(I2S_DAC1/J4) is now J10 on the DAC sheet: it

ADDR/DATA MUX/DEMUX

Latches BUSOE low after ADS is toggled for the first time, sets high on RESET

Saves PIO instructions due to JMP limitations DACK INVERT

Filtered DAC AVDD and op-amp supplies (see wavetable sheet)
PicoGUS v1.2 (SMD) with Waveblaster header, WT volume + op-amp mixer

Size: A4 | Rev: v1.3.0
KiCad E.D.A. 10.0.6 | Id: 1/3

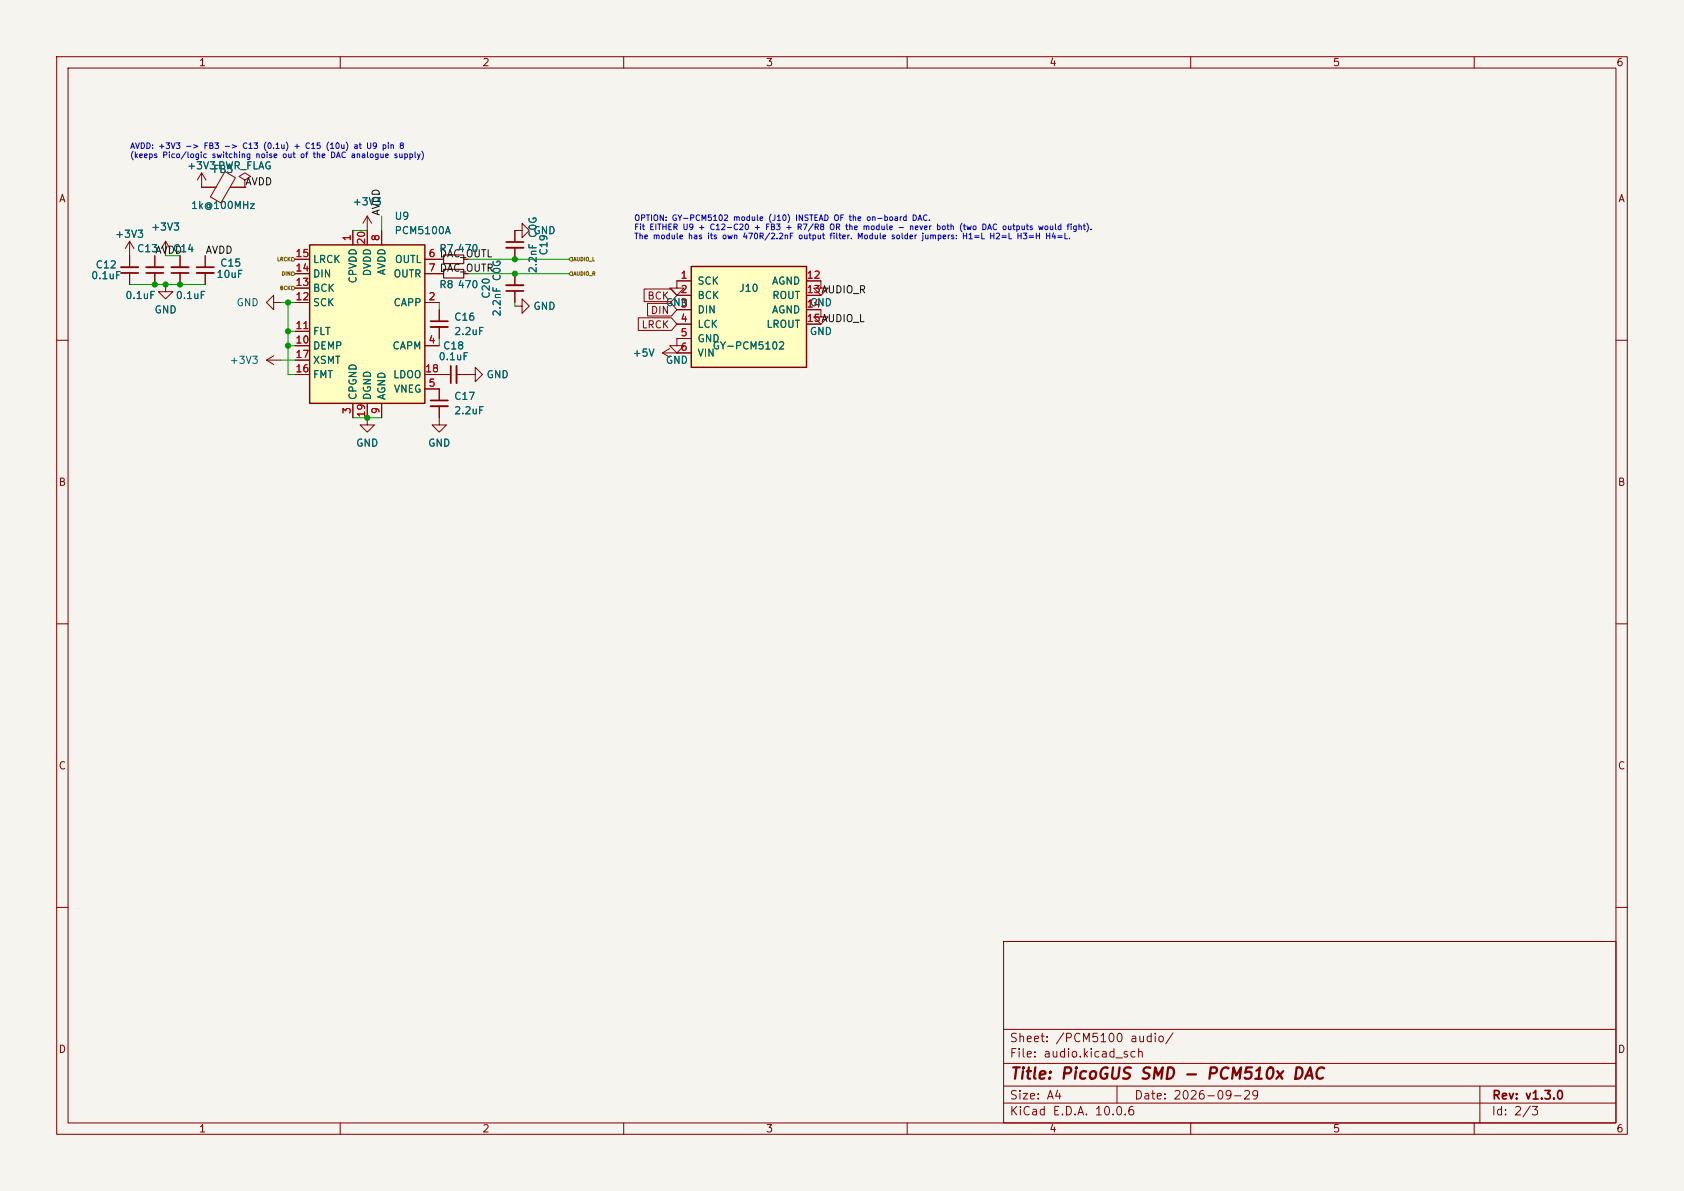
[picture p24: page 2]

(keeps Pico/logic switching noise out of the DAC analogue supply) C15

SCK 12 BCK 13 DIN 14 LRCK 15

Sheet: /PCM5100 audio/
File: audio.kicad_sch
Title: PicoGUS SMD - PCM510x DAC

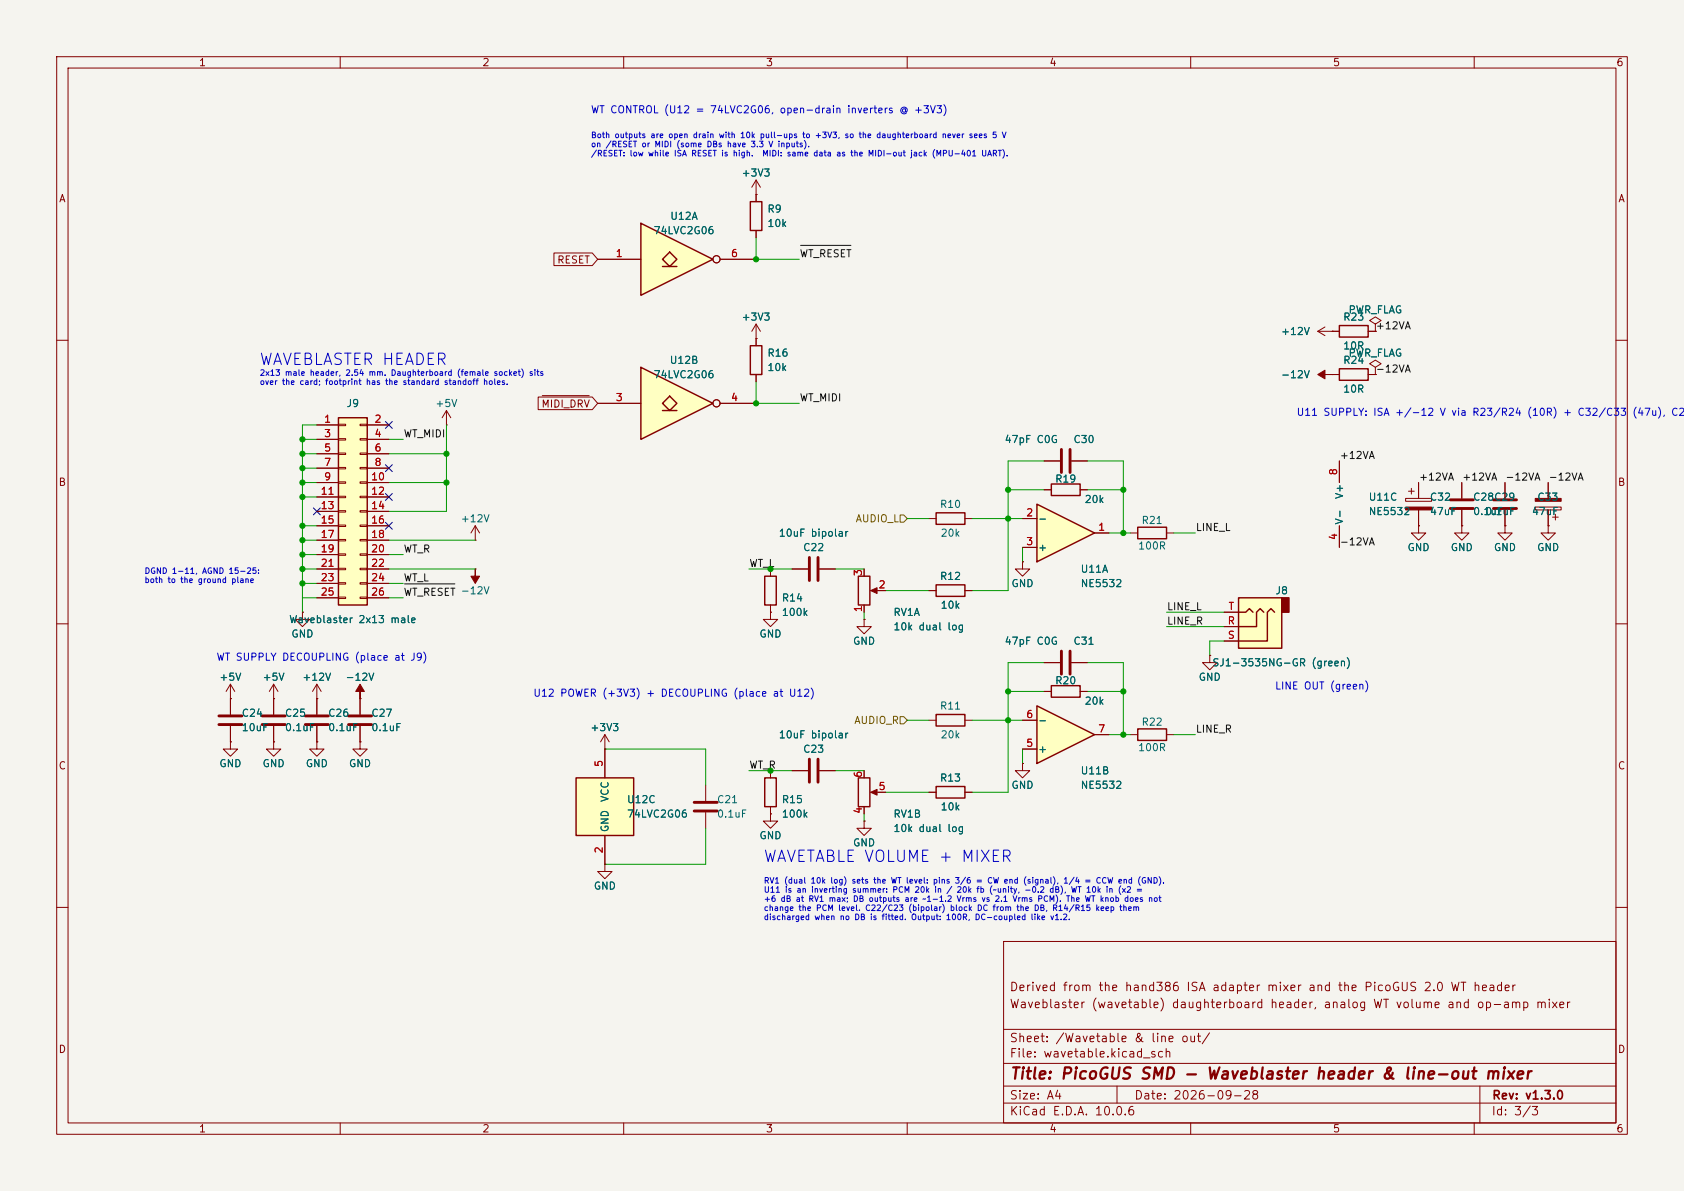
[picture p25: page 3]

2x13 male header, 2.54 mm. Daughterboard (female socket) sits over the card; footprint has the standard standoff holes. DGND 1-11, AGND 15-25: both to the ground plane WAVEBLASTER HEADER

Derived from the hand386 ISA adapter mixer and the PicoGUS 2.0 WT header C28
47uF GND

discharged when no DB is fitted. Output: 100R, DC-coupled like v1.2. WAVETABLE VOLUME + MIXER

RV1 (dual 10k log) sets the WT level: pins 3/6 = CW end (signal), 1/4 = CCW end (GND). U11 is an inverting summer: PCM 20k in / 20k fb (~unity, -0.2 dB), WT 10k in (x2 =

+6 dB at RV1 max; DB outputs are ~1-1.2 Vrms vs 2.1 Vrms PCM). The WT knob does not change the PCM level. C22/C23 (bipolar) block DC from the DB, R14/R15 keep them

Waveblaster (wavetable) daughterboard header, analog WT volume and op-amp mixer

Sheet: /Wavetable & line out/
File: wavetable.kicad_sch
Title: PicoGUS SMD - Waveblaster header & line-out mixer
