waagbo/picogus-tht/hw-tht-v1.3/PicoGUS-THT.kicad_pcb

## KiCad design hw-tht-v1.3/PicoGUS-THT.kicad_pcb (2026-11-11)

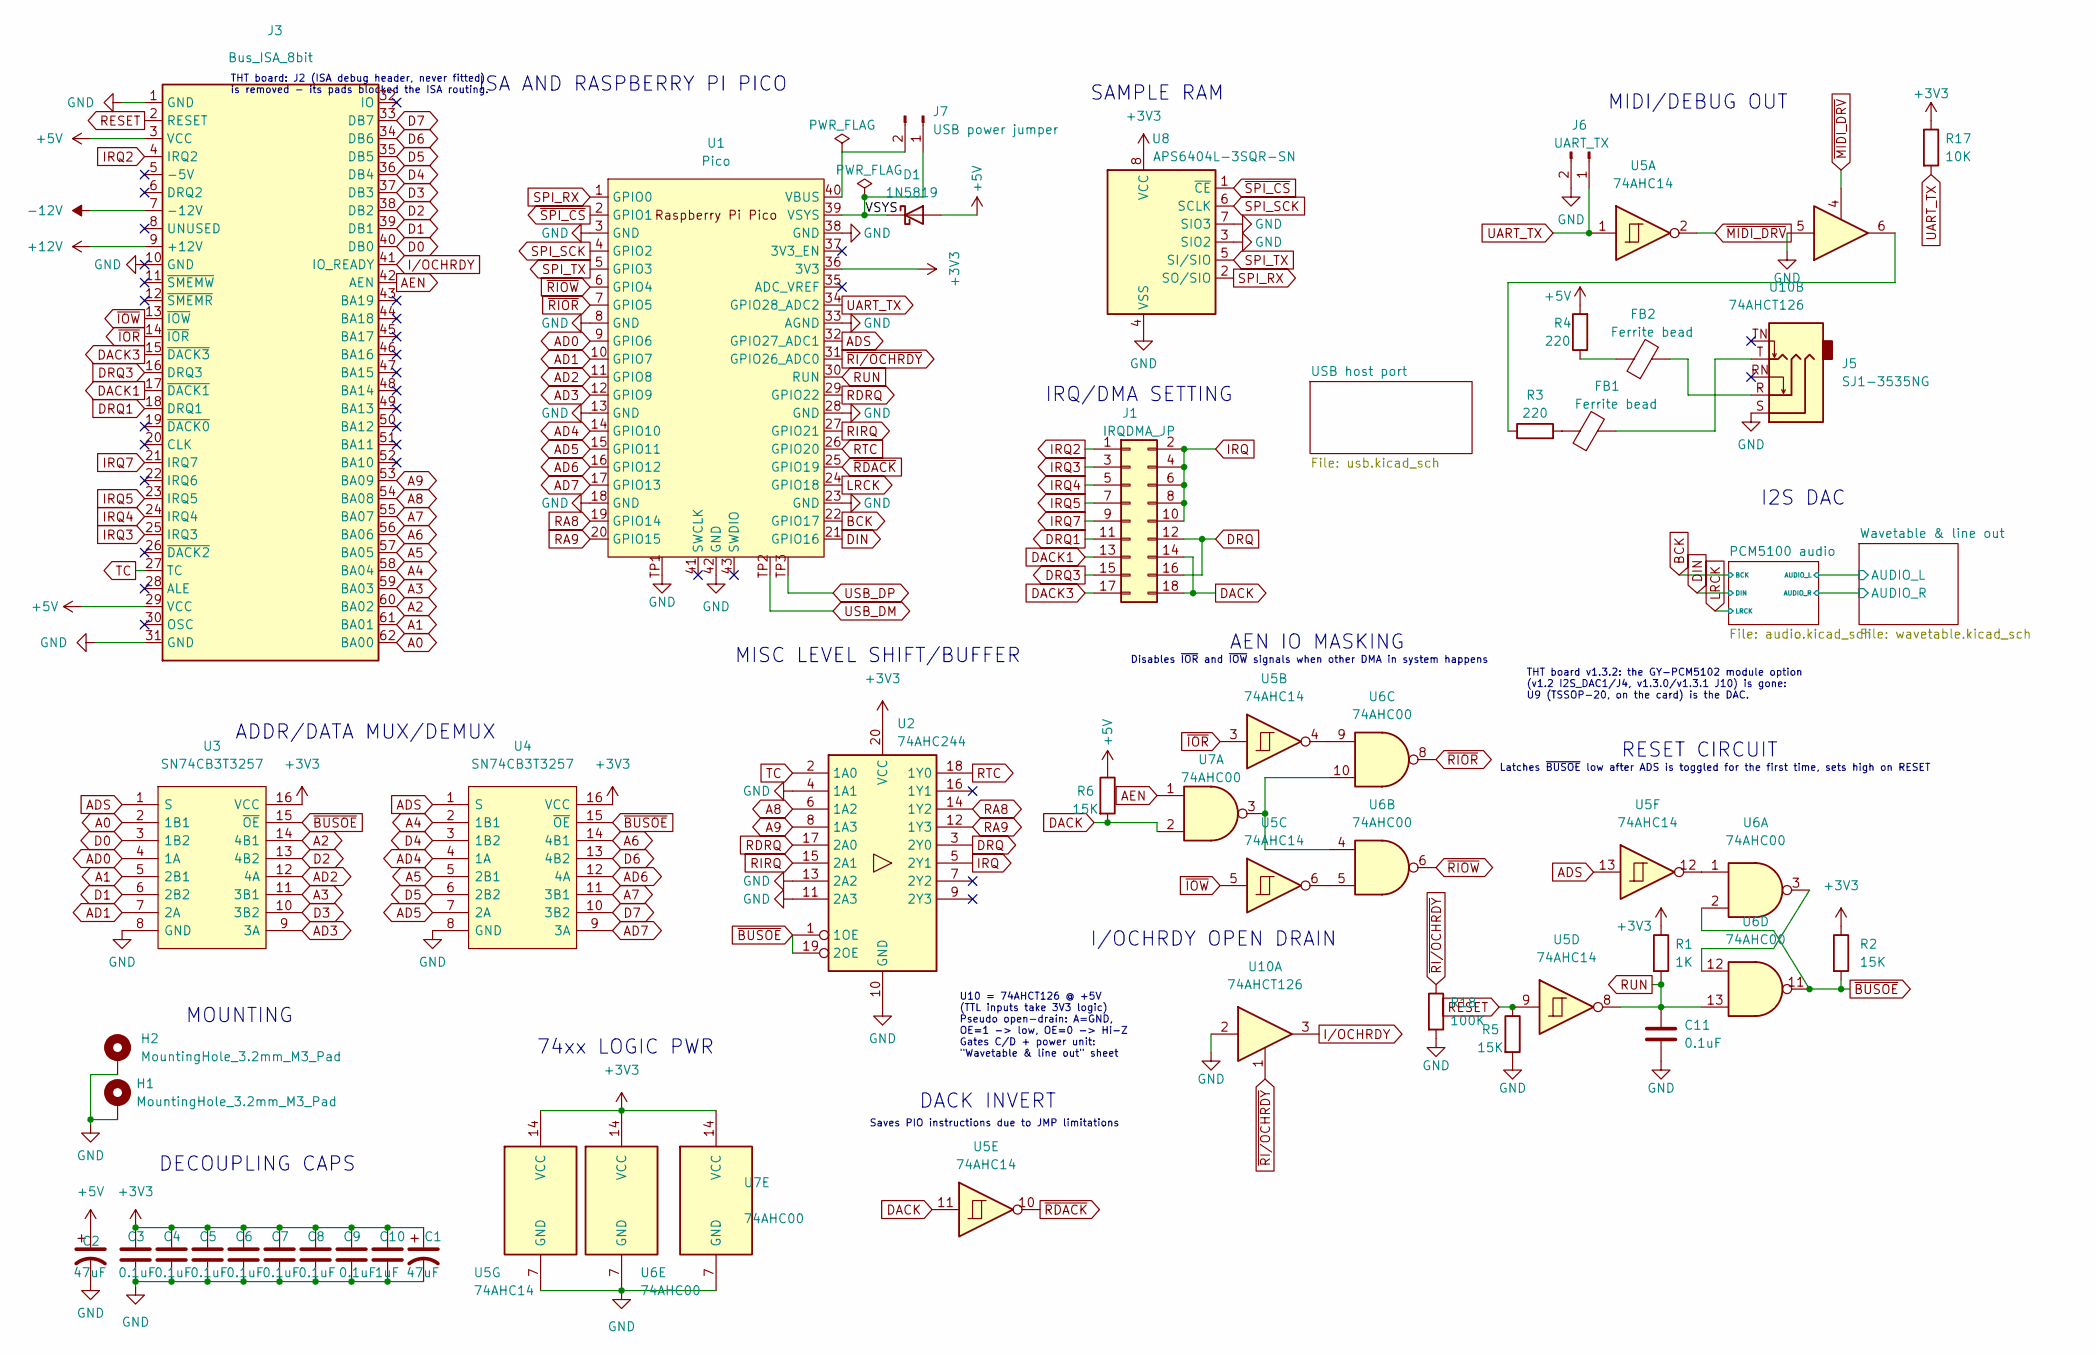
[picture p26: schematic PicoGUS-THT.kicad_sch, PicoGUS THT]

Parts:
C1, C2: 47uF; CP_Radial_D5.0mm_P2.00mm; MPN 35YXJ47M5X11; DigiKey 1189-2919-ND
C3, C4, C5, C6, C7, C8, C9, C11: 0.1uF; C_Disc_D5.0mm_W2.5mm_P5.00mm; MPN RDER71H104K0M1H03A; DigiKey 490-9144-1-ND
C10: 1uF; C_Disc_D5.0mm_W2.5mm_P5.00mm; MPN RDER71H105K2M1H03A; DigiKey 490-9146-1-ND
D1: 1N5819; D_DO-41_SOD81_P10.16mm_Horizontal; MPN 1N5819RLG; DigiKey 1N5819RLGOSCT-ND
FB1, FB2: Ferrite bead; R_Axial_DIN0309_L9.0mm_D3.2mm_P12.70mm_Horizontal; MPN 2743002112; DigiKey 1934-1477-1-ND
H1, H2: MountingHole_3.2mm_M3_Pad
J1: IRQDMA_JP; PinHeader_2x09_P2.54mm_Vertical; MPN 77313-118-18LF; DigiKey 609-77313-118-18LF-ND
J3: Bus_ISA_8bit; BUS_PC_chamfer
J5: SJ1-3535NG; Jack_3.5mm_CUI_SJ1-3535NG_Horizontal; MPN SJ1-3535NG; DigiKey CP1-3535NG-ND
J6: UART_TX; PinHeader_1x02_P2.54mm_Vertical; MPN 77311-118-02LF; DigiKey 609-4434-ND
J7: USB power jumper; PinHeader_1x02_P2.54mm_Vertical; MPN 77311-118-02LF; DigiKey 609-4434-ND
R1: 1K; R_Axial_DIN0207_L6.3mm_D2.5mm_P10.16mm_Horizontal; MPN MFR-25FBF52-1K; DigiKey 1.00KXBK-ND
R2, R5, R6: 15K; R_Axial_DIN0207_L6.3mm_D2.5mm_P10.16mm_Horizontal; MPN MFR-25FBF52-15K; DigiKey 15.0KXBK-ND
R3, R4: 220; R_Axial_DIN0207_L6.3mm_D2.5mm_P10.16mm_Horizontal; MPN RNMF14FTC220R; DigiKey S220CACT-ND
R17: 10K; R_Axial_DIN0207_L6.3mm_D2.5mm_P10.16mm_Horizontal; MPN MFR-25FBF52-10K; DigiKey 10.0KXBK-ND
R18: 100K; R_Axial_DIN0207_L6.3mm_D2.5mm_P10.16mm_Horizontal; MPN MFR-25FBF52-100K; DigiKey 100KXBK-ND
U1: Pico; RPi_Pico_SMD_TH_USB_NoSWD; MPN SC0915; DigiKey 2648-SC0915CT-ND
U2: 74AHC244; DIP-20_W7.62mm; MPN SN74AHC244N; DigiKey 296-4585-5-ND
U3, U4: SN74CB3T3257; TSSOP-16_4.4x5mm_P0.65mm_HandSolder_TestPads; MPN SN74CB3T3257PWR; DigiKey 296-17850-1-ND
U5: 74AHC14; DIP-14_W7.62mm; MPN SN74AHC14N; DigiKey 296-4550-5-ND
U6, U7: 74AHC00; DIP-14_W7.62mm; MPN SN74AHC00N; DigiKey 296-4510-5-ND
U8: APS6404L-3SQR-SN; SOIC-8_3.9x4.9mm_P1.27mm; MPN APS6404L-3SQR-SN; DigiKey 1528-4677-ND (Adafruit 4677 (64Mbit QSP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
U10: 74AHCT126; DIP-14_W7.62mm; MPN SN74AHCT126N; DigiKey 296-4659-5-ND

Connections:
+3V3: C1.1, C3.1, C4.1, C5.1, C6.1, C7.1, C8.1, C9.1, C10.1, R1.1, R2.1, R17.1, U1.36 (3V3), U2.20 (VCC), U3.16 (VCC), U4.16 (VCC), U5.14 (VCC), U6.14 (VCC), U7.14 (VCC), U8.8 (VCC); also elsewhere on the board
+5V: C2.1, D1.2 (A), J3.3 (VCC), J3.29 (VCC), R4.2, R6.1; also elsewhere on the board
+12V: J3.9 (+12V); also elsewhere on the board
-12V: J3.7 (-12V); also elsewhere on the board
/VSYS: D1.1 (K), J7.1, U1.39 (VSYS)
A0: J3.62 (BA00), U3.2 (1B1)
A1: J3.61 (BA01), U3.5 (2B1)
A2: J3.60 (BA02), U3.14 (4B1)
A3: J3.59 (BA03), U3.11 (3B1)
A4: J3.58 (BA04), U4.2 (1B1)
A5: J3.57 (BA05), U4.5 (2B1)
A6: J3.56 (BA06), U4.14 (4B1)
A7: J3.55 (BA07), U4.11 (3B1)
A8: J3.54 (BA08), U2.6 (1A2)
A9: J3.53 (BA09), U2.8 (1A3)
AD0: U1.9 (GPIO6), U3.4 (1A)
AD1: U1.10 (GPIO7), U3.7 (2A)
AD2: U1.11 (GPIO8), U3.12 (4A)
AD3: U1.12 (GPIO9), U3.9 (3A)
AD4: U1.14 (GPIO10), U4.4 (1A)
AD5: U1.15 (GPIO11), U4.7 (2A)
AD6: U1.16 (GPIO12), U4.12 (4A)
AD7: U1.17 (GPIO13), U4.9 (3A)
ADS: U1.32 (GPIO27_ADC1), U3.1 (S), U4.1 (S), U5.13
AEN: J3.42 (AEN), U7.1
BCK: U1.22 (GPIO17); also elsewhere on the board
D0: J3.40 (DB0), U3.3 (1B2)
D1: J3.39 (DB1), U3.6 (2B2)
D2: J3.38 (DB2), U3.13 (4B2)
D3: J3.37 (DB3), U3.10 (3B2)
D4: J3.36 (DB4), U4.3 (1B2)
D5: J3.35 (DB5), U4.6 (2B2)
D6: J3.34 (DB6), U4.13 (4B2)
D7: J3.33 (DB7), U4.10 (3B2)
DACK: J1.14, J1.18, R6.2, U5.11, U7.2
DACK1: J1.13, J3.17 (~DACK1)
DACK3: J1.17, J3.15 (~DACK3)
DIN: U1.21 (GPIO16); also elsewhere on the board
DRQ: J1.12, J1.16, U2.3 (2Y0)
DRQ1: J1.11, J3.18 (DRQ1)
DRQ3: J1.15, J3.16 (DRQ3)
GND: C1.2, C2.2, C3.2, C4.2, C5.2, C6.2, C7.2, C8.2, C9.2, C10.2, C11.2, H1.1, H2.1, J3.1 (GND), J3.10 (GND), J3.31 (GND), J5.S, J6.2, R5.2, R18.2, U1.3 (GND), U1.8 (GND), U1.13 (GND), U1.18 (GND), U1.23 (GND), U1.28 (GND), U1.33 (AGND), U1.38 (GND), U1.42 (GND), U1.TP1, U2.4 (1A1), U2.10 (GND), U2.11 (2A3), U2.13 (2A2), U3.8 (GND), U4.8 (GND), U5.7 (GND), U6.7 (GND), U7.7 (GND), U8.3 (SIO2), U8.4 (VSS), U8.7 (SIO3), U10.2, U10.5; also elsewhere on the board
IRQ: J1.2, J1.4, J1.6, J1.8, J1.10, U2.5 (2Y1)
IRQ2: J1.1, J3.4 (IRQ2)
IRQ3: J1.3, J3.25 (IRQ3)
IRQ4: J1.5, J3.24 (IRQ4)
IRQ5: J1.7, J3.23 (IRQ5)
IRQ7: J1.9, J3.21 (IRQ7)
I/OCHRDY: J3.41 (IO_READY), U10.3
LRCK: U1.24 (GPIO18); also elsewhere on the board
unnamed: FB1.1, R3.2
unnamed: FB1.2, J5.T
unnamed: FB2.1, R4.1
unnamed: FB2.2, J5.R
unnamed: J7.2, U1.40 (VBUS)
unnamed: R3.1, U10.6
unnamed: U5.4, U6.9
unnamed: U5.6, U6.5
unnamed: U5.12, U6.1
unnamed: U6.4, U6.10, U7.3
unnamed: U6.3, U6.12
RA8: U1.19 (GPIO14), U2.14 (1Y2)
RA9: U1.20 (GPIO15), U2.12 (1Y3)
RDRQ: U1.29 (GPIO22), U2.17 (2A0)
RESET: J3.2 (RESET), R5.1, U5.9; also elsewhere on the board
RIRQ: U1.27 (GPIO21), U2.15 (2A1)
RTC: U1.26 (GPIO20), U2.18 (1Y0)
RUN: C11.1, R1.2, U1.30 (RUN), U5.8, U6.13
SPI_RX: U1.1 (GPIO0), U8.2 (SO/SIO)
SPI_SCK: U1.4 (GPIO2), U8.6 (SCLK)
SPI_TX: U1.5 (GPIO3), U8.5 (SI/SIO)
TC: J3.27 (TC), U2.2 (1A0)
UART_TX: J6.1, R17.2, U1.34 (GPIO28_ADC2), U5.1
USB_DM: U1.TP2; also elsewhere on the board
USB_DP: U1.TP3; also elsewhere on the board
~BUSOE: R2.2, U2.1 (1OE), U2.19 (2OE), U3.15 (~OE), U4.15 (~OE), U6.2, U6.11
~IOR: J3.14 (~IOR), U5.3
~IOW: J3.13 (~IOW), U5.5
~MIDI_DRV: U5.2, U10.4; also elsewhere on the board
~RDACK: U1.25 (GPIO19), U5.10
~RIOR: U1.7 (GPIO5), U6.8
~RIOW: U1.6 (GPIO4), U6.6
~RI/OCHRDY: R18.1, U1.31 (GPIO26_ADC0), U10.1
~SPI_CS: U1.2 (GPIO1), U8.1 (~CE)

Notes on the sheet:
Saves PIO instructions due to JMP limitations
DECOUPLING CAPS
I2S DAC
Disables ~{IOR} and ~{IOW} signals when other DMA in system happens
Latches ~{BUSOE} low after ADS is toggled for the first time, sets high on RESET
MIDI/DEBUG OUT
MOUNTING
MISC LEVEL SHIFT/BUFFER
IRQ/DMA SETTING
DACK INVERT
ADDR/DATA MUX/DEMUX
SAMPLE RAM
AEN IO MASKING
ISA AND RASPBERRY PI PICO
RESET CIRCUIT
I/OCHRDY OPEN DRAIN
74xx LOGIC PWR
U10 = 74AHCT126 @ +5V (TTL inputs take 3V3 logic) Pseudo open-drain: A=GND, OE=1 -> low, OE=0 -> Hi-Z Gates C/D + power unit: "Wavetable & line out" sheet
THT board v1.3.2: the GY-PCM5102 module option (v1.2 I2S_DAC1/J4, v1.3.0/v1.3.1 J10) is gone: U9 (TSSOP-20, on the card) is the DAC.
THT board: J2 (ISA debug header, never fitted) is removed - its pads blocked the ISA routing.

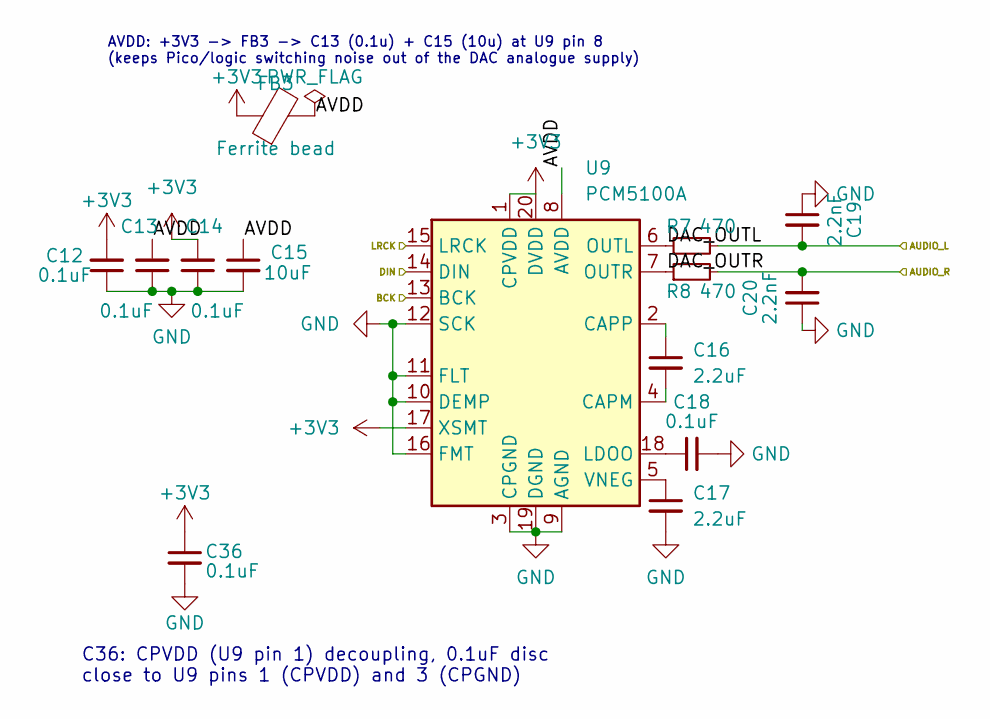
[picture p27: schematic audio.kicad_sch, PicoGUS THT - PCM510x DAC]

Parts:
C12, C13, C14, C18, C36: 0.1uF; C_Disc_D5.0mm_W2.5mm_P5.00mm; MPN RDER71H104K0M1H03A; DigiKey 490-9144-1-ND
C15: 10uF; C_Disc_D5.0mm_W2.5mm_P5.00mm; MPN RCER71H106MWK1H03B; DigiKey 490-11888-ND
C16, C17: 2.2uF; C_Disc_D5.0mm_W2.5mm_P5.00mm; MPN FG24X7R1H225KRT06; DigiKey 445-173378-1-ND
C19, C20: 2.2nF; C_Disc_D5.0mm_W2.5mm_P5.00mm; MPN FG28C0G1H222JNT06; DigiKey 445-173487-1-ND
FB3: Ferrite bead; R_Axial_DIN0309_L9.0mm_D3.2mm_P12.70mm_Horizontal; MPN 2743002112; DigiKey 1934-1477-1-ND
R7, R8: 470; R_Axial_DIN0207_L6.3mm_D2.5mm_P10.16mm_Horizontal; MPN RNMF14FTC470R; DigiKey S470CACT-ND
U9: PCM5100A; TSSOP-20_4.4x6.5mm_P0.65mm_HandSolder_TestPads; MPN PCM5100APWR; DigiKey 296-36705-1-ND

Connections:
+3V3: C12.2, C14.2, C36.1, FB3.1, U9.1 (CPVDD), U9.17 (XSMT), U9.20 (DVDD); also elsewhere on the board
/PCM5100 audio/AUDIO_L: C19.2, R7.2; also elsewhere on the board
/PCM5100 audio/AUDIO_R: C20.2, R8.2; also elsewhere on the board
/PCM5100 audio/AVDD: C13.2, C15.1, FB3.2, U9.8 (AVDD)
/PCM5100 audio/DAC_OUTL: R7.1, U9.6 (OUTL)
/PCM5100 audio/DAC_OUTR: R8.1, U9.7 (OUTR)
BCK: U9.13 (BCK); also elsewhere on the board
DIN: U9.14 (DIN); also elsewhere on the board
GND: C12.1, C13.1, C14.1, C15.2, C17.2, C18.2, C19.1, C20.1, C36.2, U9.3 (CPGND), U9.9 (AGND), U9.10 (DEMP), U9.11 (FLT), U9.12 (SCK), U9.16 (FMT), U9.19 (DGND); also elsewhere on the board
LRCK: U9.15 (LRCK); also elsewhere on the board
unnamed: C16.2, U9.4 (CAPM)
unnamed: C16.1, U9.2 (CAPP)
unnamed: C18.1, U9.18 (LDOO)
unnamed: C17.1, U9.5 (VNEG)

Notes on the sheet:
AVDD: +3V3 -> FB3 -> C13 (0.1u) + C15 (10u) at U9 pin 8 (keeps Pico/logic switching noise out of the DAC analogue supply)
C36: CPVDD (U9 pin 1) decoupling, 0.1uF disc close to U9 pins 1 (CPVDD) and 3 (CPGND)

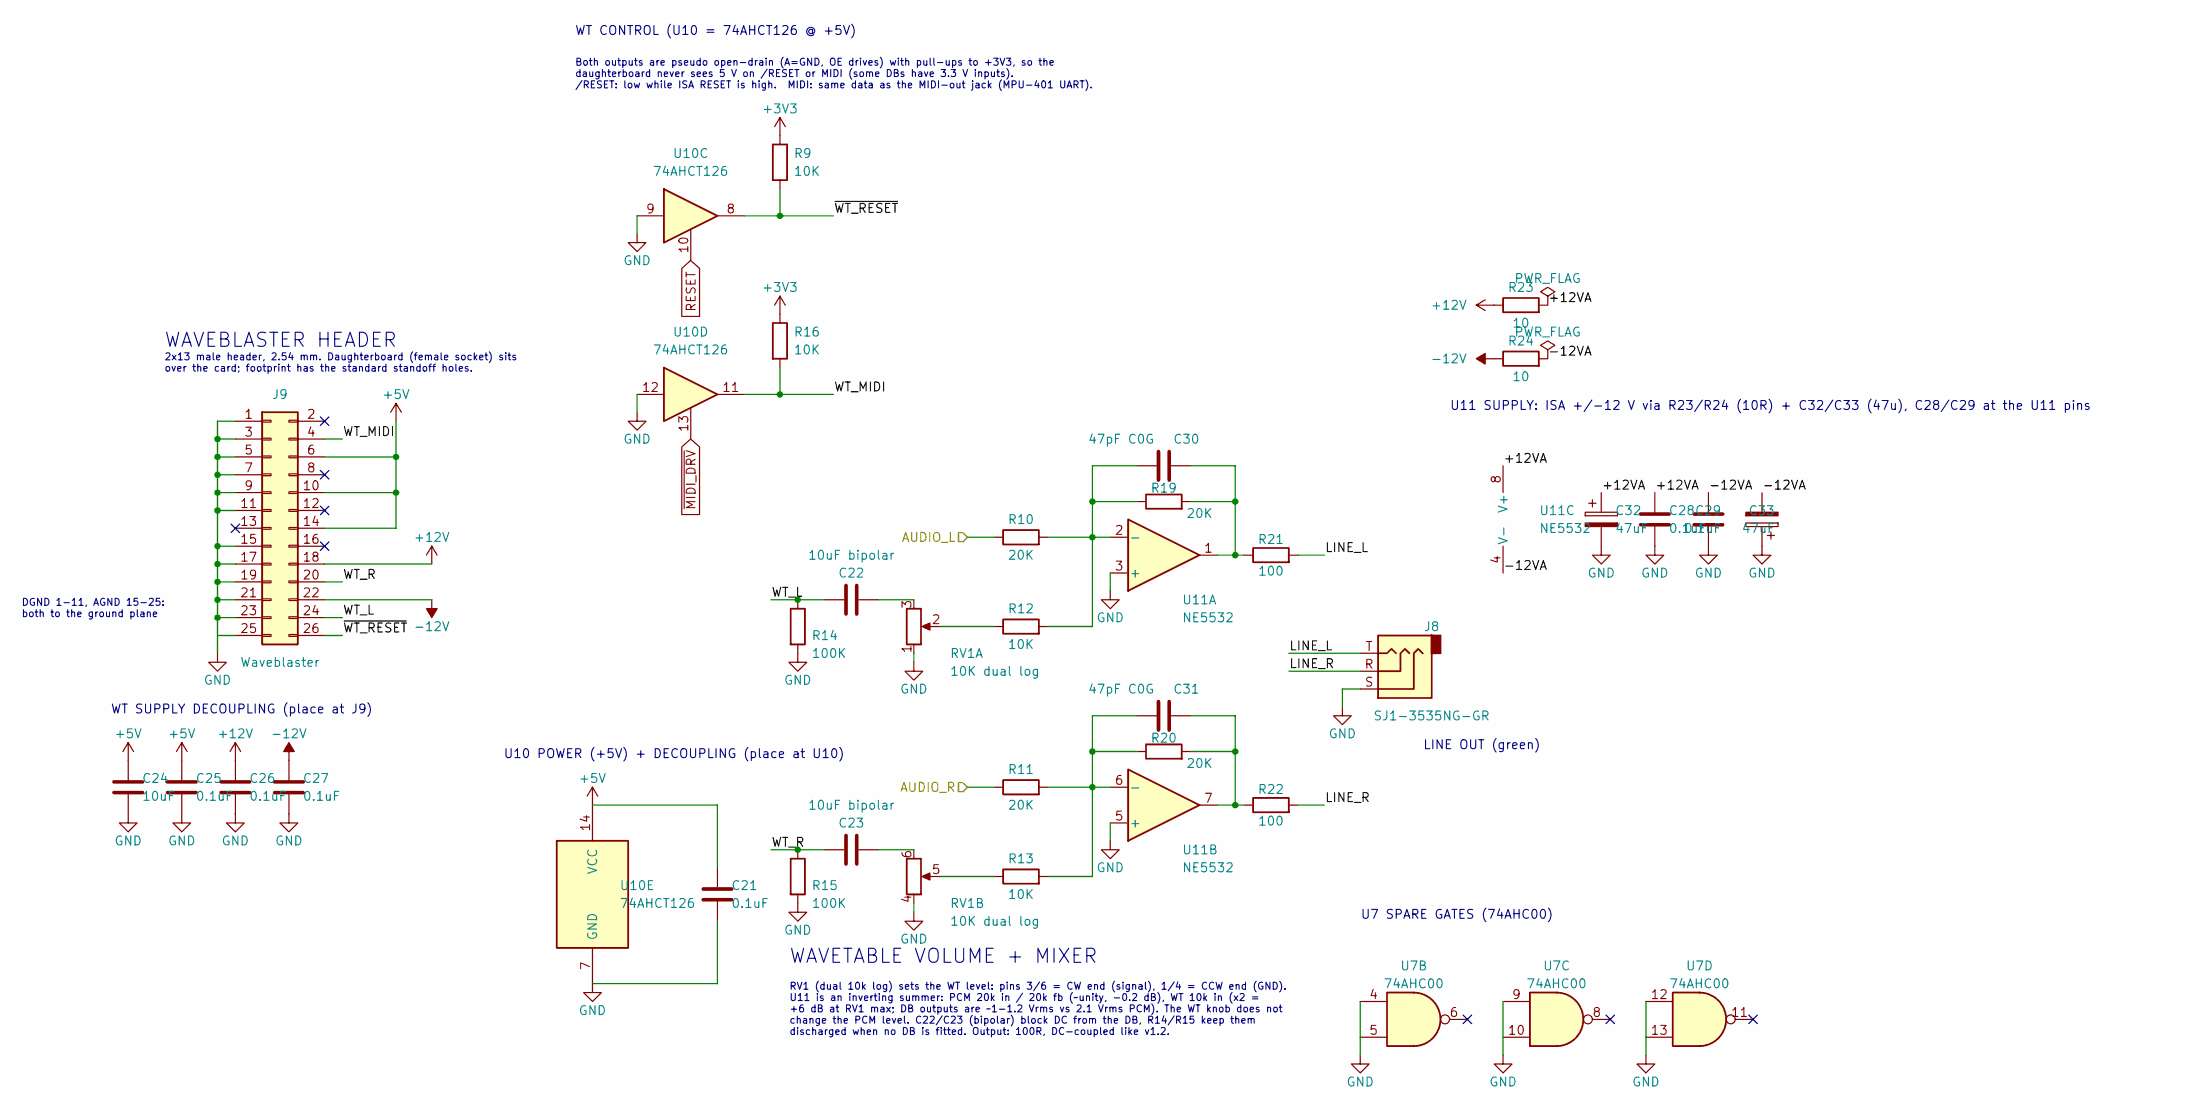
[picture p28: schematic wavetable.kicad_sch, PicoGUS THT - Waveblaster header & line-out mixer]

Parts:
C21, C25, C26, C27, C28, C29: 0.1uF; C_Disc_D5.0mm_W2.5mm_P5.00mm; MPN RDER71H104K0M1H03A; DigiKey 490-9144-1-ND
C22, C23: 10uF bipolar; C_Radial_D6.3mm_H11.0mm_P2.50mm; MPN ECE-A1HN100U; DigiKey P1280-ND
C24: 10uF; C_Disc_D5.0mm_W2.5mm_P5.00mm; MPN RCER71H106MWK1H03B; DigiKey 490-11888-ND
C30, C31: 47pF C0G; C_Disc_D5.0mm_W2.5mm_P5.00mm; MPN K470J15C0GF5TH5; DigiKey BC1038CT-ND
C32, C33: 47uF; CP_Radial_D5.0mm_P2.00mm; MPN 35YXJ47M5X11; DigiKey 1189-2919-ND
J8: SJ1-3535NG-GR; Jack_3.5mm_CUI_SJ1-3535NG_Horizontal; MPN SJ1-3535NG-GR; DigiKey CP1-3535NG-GR-ND
J9: Waveblaster; Wavetable_NoMountingHoles; MPN 77313-118-26LF; DigiKey 609-5706-ND
R9, R12, R13, R16: 10K; R_Axial_DIN0207_L6.3mm_D2.5mm_P10.16mm_Horizontal; MPN MFR-25FBF52-10K; DigiKey 10.0KXBK-ND
R10, R11, R19, R20: 20K; R_Axial_DIN0207_L6.3mm_D2.5mm_P10.16mm_Horizontal; MPN MFR-25FBF52-20K; DigiKey 20.0KXBK-ND
R14, R15: 100K; R_Axial_DIN0207_L6.3mm_D2.5mm_P10.16mm_Horizontal; MPN MFR-25FBF52-100K; DigiKey 100KXBK-ND
R21, R22: 100; R_Axial_DIN0207_L6.3mm_D2.5mm_P10.16mm_Horizontal; MPN MFR-25FBF52-100R; DigiKey 100XBK-ND
R23, R24: 10; R_Axial_DIN0207_L6.3mm_D2.5mm_P10.16mm_Horizontal; MPN MFR-25FBF52-10R; DigiKey 10.0XBK-ND
RV1: 10K dual log; Potentiometer_Alps_RK097_Dual_Horizontal_Switch; MPN PTD902-2020K-A103; DigiKey PTD902-2020K-A103-ND
U7: 74AHC00; DIP-14_W7.62mm; MPN SN74AHC00N; DigiKey 296-4510-5-ND
U10: 74AHCT126; DIP-14_W7.62mm; MPN SN74AHCT126N; DigiKey 296-4659-5-ND
U11: NE5532; DIP-8_W7.62mm; MPN NE5532P; DigiKey 296-1410-5-ND

Connections:
+3V3: R9.1, R16.1; also elsewhere on the board
+5V: C21.1, C24.1, C25.1, J9.6, J9.10, J9.14, U10.14 (VCC); also elsewhere on the board
+12V: C26.1, J9.18, R23.1; also elsewhere on the board
-12V: C27.1, J9.22, R24.1; also elsewhere on the board
/PCM5100 audio/AUDIO_L: R10.1; also elsewhere on the board
/PCM5100 audio/AUDIO_R: R11.1; also elsewhere on the board
/Wavetable & line out/+12VA: C28.1, C32.1, R23.2, U11.8 (V+)
/Wavetable & line out/-12VA: C29.2, C33.2, R24.2, U11.4 (V-)
/Wavetable & line out/LINE_L: J8.T, R21.2
/Wavetable & line out/LINE_R: J8.R, R22.2
/Wavetable & line out/WT_L: C22.1, J9.24, R14.1
/Wavetable & line out/WT_MIDI: J9.4, R16.2, U10.11
/Wavetable & line out/WT_R: C23.1, J9.20, R15.1
/Wavetable & line out/~WT_RESET: J9.26, R9.2, U10.8
GND: C21.2, C24.2, C25.2, C26.2, C27.2, C28.2, C29.1, C32.2, C33.1, J8.S, J9.1, J9.3, J9.5, J9.7, J9.9, J9.11, J9.15, J9.17, J9.19, J9.21, J9.23, J9.25, R14.2, R15.2, RV1.1, RV1.4, U7.4, U7.5, U7.9, U7.10, U7.12, U7.13, U10.7 (GND), U10.9, U10.12, U11.3 (+), U11.5 (+); also elsewhere on the board
unnamed: C22.2, RV1.3
unnamed: C23.2, RV1.6
unnamed: C30.2, R19.2, R21.1, U11.1
unnamed: C31.2, R20.2, R22.1, U11.7
unnamed: R12.1, RV1.2
unnamed: R13.1, RV1.5
unnamed: C30.1, R10.2, R12.2, R19.1, U11.2 (-)
unnamed: C31.1, R11.2, R13.2, R20.1, U11.6 (-)
RESET: U10.10; also elsewhere on the board
~MIDI_DRV: U10.13; also elsewhere on the board

Notes on the sheet:
DGND 1-11, AGND 15-25: both to the ground plane
WAVEBLASTER HEADER
2x13 male header, 2.54 mm. Daughterboard (female socket) sits over the card; footprint has the standard standoff holes.
WT SUPPLY DECOUPLING (place at J9)
U10 POWER (+5V) + DECOUPLING (place at U10)
WT CONTROL (U10 = 74AHCT126 @ +5V)
Both outputs are pseudo open-drain (A=GND, OE drives) with pull-ups to +3V3, so the daughterboard never sees 5 V on /RESET or MIDI (some DBs have 3.3 V inputs). /RESET: low while ISA RESET is high. MIDI: same data as the MIDI-out jack (MPU-401 UART).
U11 SUPPLY: ISA +/-12 V via R23/R24 (10R) + C32/C33 (47u), C28/C29 at the U11 pins
WAVETABLE VOLUME + MIXER
RV1 (dual 10k log) sets the WT level: pins 3/6 = CW end (signal), 1/4 = CCW end (GND). U11 is an inverting summer: PCM 20k in / 20k fb (~unity, -0.2 dB), WT 10k in (x2 = +6 dB at RV1 max; DB outputs are ~1-1.2 Vrms vs 2.1 Vrms PCM). The WT knob does not change the PCM level. C22/C23 (bipolar) block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
LINE OUT (green)
U7 SPARE GATES (74AHC00)

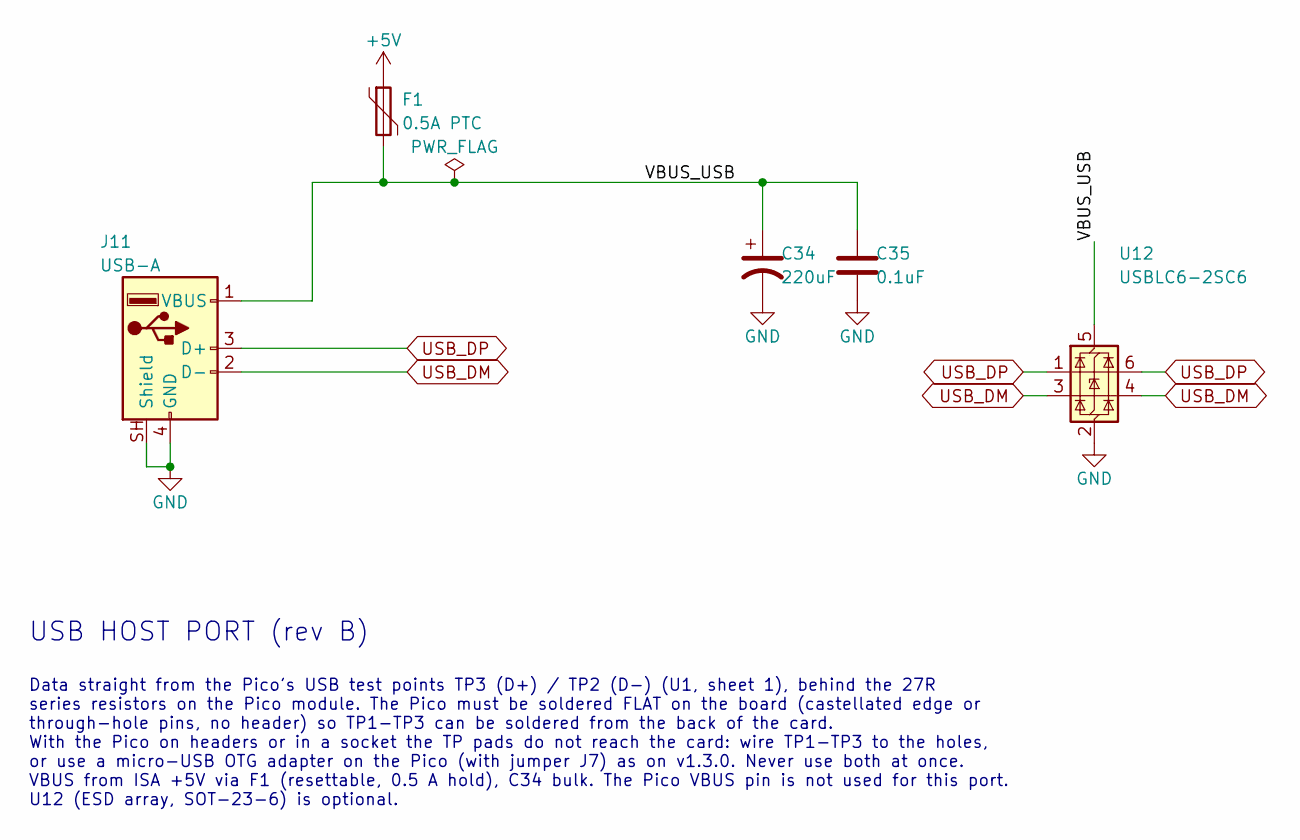
[picture p29: schematic usb.kicad_sch, PicoGUS THT - USB host port]

Parts:
C34: 220uF; CP_Radial_D6.3mm_P2.50mm; MPN 16ZLH220MEFC6.3X11; DigiKey 1189-1726-ND
C35: 0.1uF; C_Disc_D5.0mm_W2.5mm_P5.00mm; MPN RDER71H104K0M1H03A; DigiKey 490-9144-1-ND
F1: 0.5A PTC; Fuse_Bourns_MF-RHT050; MPN MF-R050; DigiKey MF-R050-ND
J11: USB-A; USB_A_Molex_67643_Horizontal; MPN 0676430910; DigiKey WM4993-ND
U12: USBLC6-2SC6; SOT-23-6; MPN USBLC6-2SC6; DigiKey 497-5235-1-ND

Connections:
+5V: F1.1; also elsewhere on the board
/USB host port/VBUS_USB: C34.1, C35.1, F1.2, J11.1 (VBUS), U12.5 (VBUS)
GND: C34.2, C35.2, J11.4 (GND), J11.SH (Shield), U12.2 (GND); also elsewhere on the board
USB_DM: J11.2 (D-), U12.3 (I/O2), U12.4 (I/O2); also elsewhere on the board
USB_DP: J11.3 (D+), U12.1 (I/O1), U12.6 (I/O1); also elsewhere on the board

Notes on the sheet:
USB HOST PORT (rev B)
Data straight from the Pico's USB test points TP3 (D+) / TP2 (D-) (U1, sheet 1), behind the 27R series resistors on the Pico module. The Pico must be soldered FLAT on the board (castellated edge or through-hole pins, no header) so TP1-TP3 can be soldered from the back of the card. With the Pico on 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

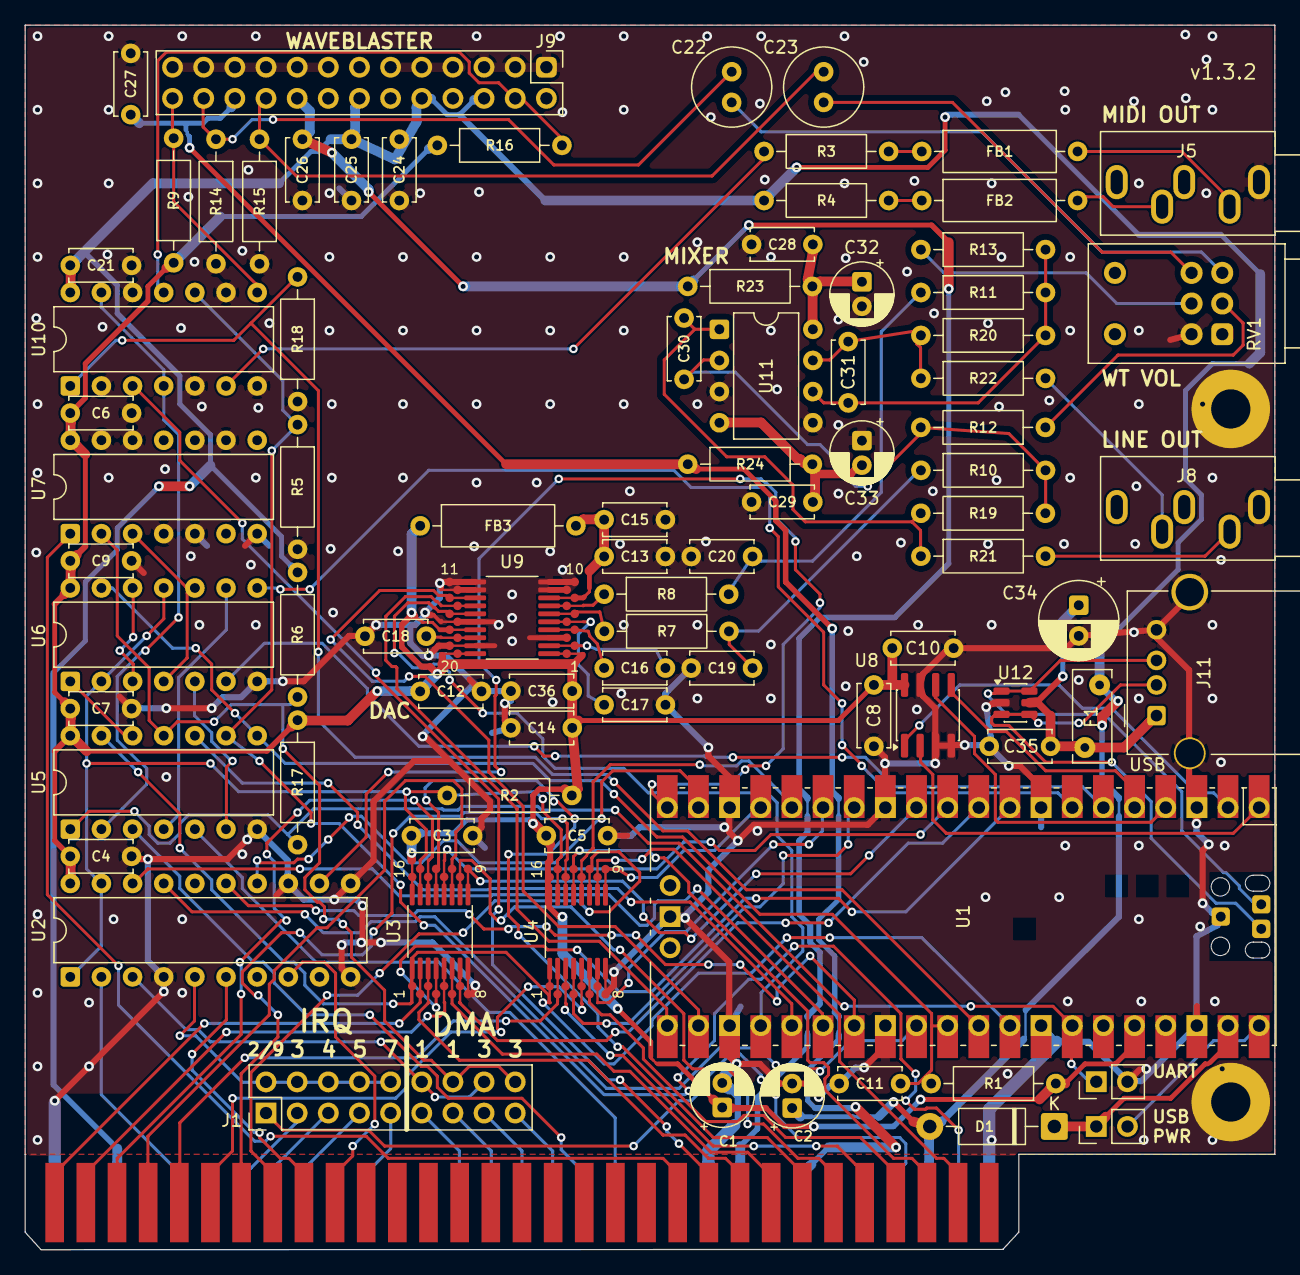
[picture p30: board PicoGUS-THT.kicad_pcb from above]

Board: 2 copper layers, 101.9 x 99.8 mm, 88 parts (0 on the bottom side), 110 nets.
