waagbo/picogus-tht/hw-ne2k/PicoGUS-NE2K.kicad_pcb

## KiCad design hw-ne2k/PicoGUS-NE2K.kicad_pcb (2026-11-07)

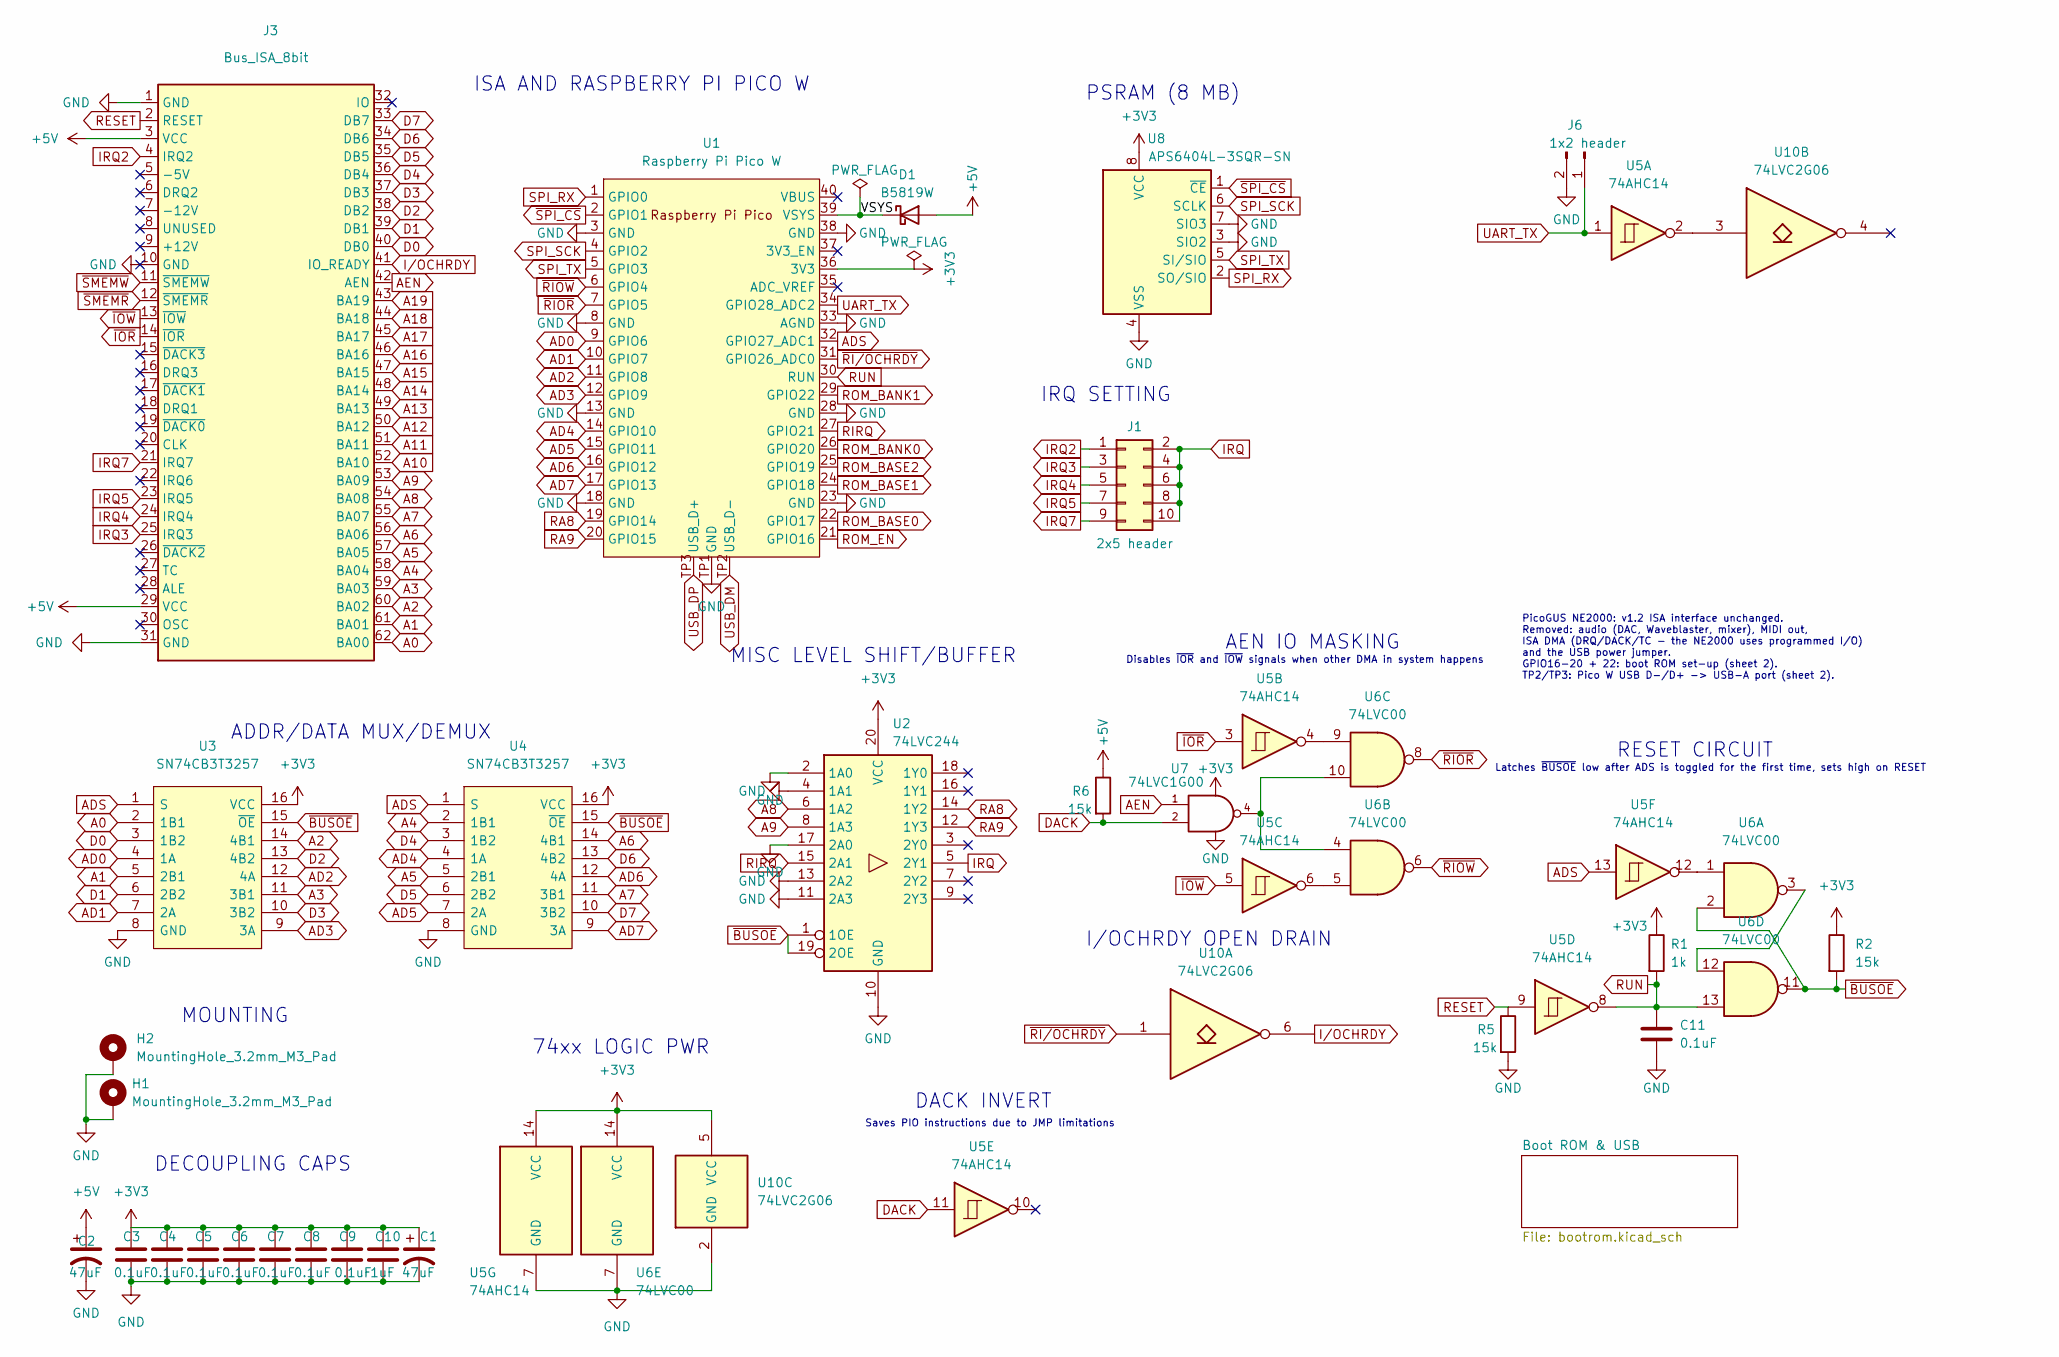
[picture p31: schematic PicoGUS-NE2K.kicad_sch, PicoGUS NE2000]

Parts:
C1, C2: 47uF; C_1206_3216Metric; MPN C3216X5R1A476M160AB; DigiKey 445-6006-1-ND
C3, C4, C5, C6, C7, C8, C9, C11: 0.1uF; C_0805_2012Metric; MPN CL21B104KBCNNNC; DigiKey 1276-1003-1-ND
C10: 1uF; C_0805_2012Metric; MPN C2012X7R1H105K125AB; DigiKey 445-7547-1-ND
D1: B5819W; D_SOD-123; MPN B5819W; DigiKey 5399-B5819WCT-ND
H1, H2: MountingHole_3.2mm_M3_Pad
J1: 2x5 header; PinHeader_2x05_P2.54mm_Vertical; MPN 10129381-910001BLF; DigiKey 10129381-910001BLF-ND
J3: Bus_ISA_8bit; BUS_PC_chamfer
J6: 1x2 header; PinHeader_1x02_P2.54mm_Vertical; MPN 77311-118-02LF; DigiKey 609-4434-ND
R1: 1k; R_0805_2012Metric; MPN RC0805FR-071KL; DigiKey 311-1.00KCRCT-ND
R2, R5, R6: 15k; R_0805_2012Metric; MPN RC0805FR-0715KL; DigiKey 311-15.0KCRCT-ND
U1: Raspberry Pi Pico W; RPi_PicoW_SMD_TH_USB; MPN SC0918; DigiKey 2648-SC0918CT-ND
U2: 74LVC244; TSSOP-20_4.4x6.5mm_P0.65mm; MPN SN74LVC244APW; DigiKey 296-26609-5-ND
U3, U4: SN74CB3T3257; TSSOP-16_4.4x5mm_P0.65mm; MPN SN74CB3T3257PWR; DigiKey 296-17850-1-ND
U5: 74AHC14; SOIC-14_3.9x8.7mm_P1.27mm; MPN 74AHC14S14-13; DigiKey 31-74AHC14S14-13CT-ND
U6: 74LVC00; SOIC-14_3.9x8.7mm_P1.27mm; MPN 74LVC00AS14-13; DigiKey 31-74LVC00AS14-13CT-ND
U7: 74LVC1G00; SOT-23-5; MPN SN74LVC1G00DBVR; DigiKey 296-9845-1-ND
U8: APS6404L-3SQR-SN; SOIC-8_3.9x4.9mm_P1.27mm; MPN APS6404L-3SQR-SN; DigiKey 1528-4677-ND
U10: 74LVC2G06; TSOP-6_1.65x3.05mm_P0.95mm; MPN SN74LVC2G06DBVR; DigiKey 296-13492-1-ND

Connections:
+3V3: C1.1, C3.1, C4.1, C5.1, C6.1, C7.1, C8.1, C9.1, C10.1, R1.1, R2.1, U1.36 (3V3), U2.20 (VCC), U3.16 (VCC), U4.16 (VCC), U5.14 (VCC), U6.14 (VCC), U7.5 (VCC), U8.8 (VCC), U10.5 (VCC)
+5V: C2.1, D1.2 (A), J3.3 (VCC), J3.29 (VCC), R6.1; also elsewhere on the board
/VSYS: D1.1 (K), U1.39 (VSYS)
A0: J3.62 (BA00), U3.2 (1B1); also elsewhere on the board
A1: J3.61 (BA01), U3.5 (2B1); also elsewhere on the board
A2: J3.60 (BA02), U3.14 (4B1); also elsewhere on the board
A3: J3.59 (BA03), U3.11 (3B1); also elsewhere on the board
A4: J3.58 (BA04), U4.2 (1B1); also elsewhere on the board
A5: J3.57 (BA05), U4.5 (2B1); also elsewhere on the board
A6: J3.56 (BA06), U4.14 (4B1); also elsewhere on the board
A7: J3.55 (BA07), U4.11 (3B1); also elsewhere on the board
A8: J3.54 (BA08), U2.6 (1A2); also elsewhere on the board
A9: J3.53 (BA09), U2.8 (1A3); also elsewhere on the board
A10: J3.52 (BA10); also elsewhere on the board
A11: J3.51 (BA11); also elsewhere on the board
A12: J3.50 (BA12); also elsewhere on the board
A13: J3.49 (BA13); also elsewhere on the board
A14: J3.48 (BA14); also elsewhere on the board
A15: J3.47 (BA15); also elsewhere on the board
A16: J3.46 (BA16); also elsewhere on the board
A17: J3.45 (BA17); also elsewhere on the board
A18: J3.44 (BA18); also elsewhere on the board
A19: J3.43 (BA19); also elsewhere on the board
AD0: U1.9 (GPIO6), U3.4 (1A)
AD1: U1.10 (GPIO7), U3.7 (2A)
AD2: U1.11 (GPIO8), U3.12 (4A)
AD3: U1.12 (GPIO9), U3.9 (3A)
AD4: U1.14 (GPIO10), U4.4 (1A)
AD5: U1.15 (GPIO11), U4.7 (2A)
AD6: U1.16 (GPIO12), U4.12 (4A)
AD7: U1.17 (GPIO13), U4.9 (3A)
ADS: U1.32 (GPIO27_ADC1), U3.1 (S), U4.1 (S), U5.13
AEN: J3.42 (AEN), U7.1
D0: J3.40 (DB0), U3.3 (1B2); also elsewhere on the board
D1: J3.39 (DB1), U3.6 (2B2); also elsewhere on the board
D2: J3.38 (DB2), U3.13 (4B2); also elsewhere on the board
D3: J3.37 (DB3), U3.10 (3B2); also elsewhere on the board
D4: J3.36 (DB4), U4.3 (1B2); also elsewhere on the board
D5: J3.35 (DB5), U4.6 (2B2); also elsewhere on the board
D6: J3.34 (DB6), U4.13 (4B2); also elsewhere on the board
D7: J3.33 (DB7), U4.10 (3B2); also elsewhere on the board
DACK: R6.2, U5.11, U7.2
GND: C1.2, C2.2, C3.2, C4.2, C5.2, C6.2, C7.2, C8.2, C9.2, C10.2, C11.2, H1.1, H2.1, J3.1 (GND), J3.10 (GND), J3.31 (GND), J6.2, R5.2, U1.3 (GND), U1.8 (GND), U1.13 (GND), U1.18 (GND), U1.23 (GND), U1.28 (GND), U1.33 (AGND), U1.38 (GND), U1.TP1 (GND), U2.2 (1A0), U2.4 (1A1), U2.10 (GND), U2.11 (2A3), U2.13 (2A2), U2.17 (2A0), U3.8 (GND), U4.8 (GND), U5.7 (GND), U6.7 (GND), U7.3 (GND), U8.3 (SIO2), U8.4 (VSS), U8.7 (SIO3), U10.2 (GND); also elsewhere on the board
IRQ: J1.2, J1.4, J1.6, J1.8, J1.10, U2.5 (2Y1)
IRQ2: J1.1, J3.4 (IRQ2)
IRQ3: J1.3, J3.25 (IRQ3)
IRQ4: J1.5, J3.24 (IRQ4)
IRQ5: J1.7, J3.23 (IRQ5)
IRQ7: J1.9, J3.21 (IRQ7)
I/OCHRDY: J3.41 (IO_READY), U10.6
unnamed: U5.4, U6.9
unnamed: U5.6, U6.5
unnamed: U5.12, U6.1
unnamed: U6.4, U6.10, U7.4
unnamed: U6.3, U6.12
unnamed: U5.2, U10.3
RA8: U1.19 (GPIO14), U2.14 (1Y2)
RA9: U1.20 (GPIO15), U2.12 (1Y3)
RESET: J3.2 (RESET), R5.1, U5.9
RIRQ: U1.27 (GPIO21), U2.15 (2A1)
ROM_BANK0: U1.26 (GPIO20); also elsewhere on the board
ROM_BANK1: U1.29 (GPIO22); also elsewhere on the board
ROM_BASE0: U1.22 (GPIO17); also elsewhere on the board
ROM_BASE1: U1.24 (GPIO18); also elsewhere on the board
ROM_BASE2: U1.25 (GPIO19); also elsewhere on the board
ROM_EN: U1.21 (GPIO16); also elsewhere on the board
RUN: C11.1, R1.2, U1.30 (RUN), U5.8, U6.13
SPI_RX: U1.1 (GPIO0), U8.2 (SO/SIO)
SPI_SCK: U1.4 (GPIO2), U8.6 (SCLK)
SPI_TX: U1.5 (GPIO3), U8.5 (SI/SIO)
UART_TX: J6.1, U1.34 (GPIO28_ADC2), U5.1
USB_DM: U1.TP2 (USB_D-); also elsewhere on the board
USB_DP: U1.TP3 (USB_D+); also elsewhere on the board
~BUSOE: R2.2, U2.1 (1OE), U2.19 (2OE), U3.15 (~OE), U4.15 (~OE), U6.2, U6.11
~IOR: J3.14 (~IOR), U5.3
~IOW: J3.13 (~IOW), U5.5
~RIOR: U1.7 (GPIO5), U6.8
~RIOW: U1.6 (GPIO4), U6.6
~RI/OCHRDY: U1.31 (GPIO26_ADC0), U10.1
~SMEMR: J3.12 (~SMEMR); also elsewhere on the board
~SMEMW: J3.11 (~SMEMW); also elsewhere on the board
~SPI_CS: U1.2 (GPIO1), U8.1 (~CE)

Notes on the sheet:
Saves PIO instructions due to JMP limitations
DECOUPLING CAPS
Disables ~{IOR} and ~{IOW} signals when other DMA in system happens
Latches ~{BUSOE} low after ADS is toggled for the first time, sets high on RESET
MOUNTING
MISC LEVEL SHIFT/BUFFER
IRQ SETTING
DACK INVERT
ADDR/DATA MUX/DEMUX
PSRAM (8 MB)
AEN IO MASKING
ISA AND RASPBERRY PI PICO W
RESET CIRCUIT
I/OCHRDY OPEN DRAIN
74xx LOGIC PWR
PicoGUS NE2000: v1.2 ISA interface unchanged. Removed: audio (DAC, Waveblaster, mixer), MIDI out, ISA DMA (DRQ/DACK/TC - the NE2000 uses programmed I/O) and the USB power jumper. GPIO16-20 + 22: boot ROM set-up (sheet 2). TP2/TP3: Pico W USB D-/D+ -> USB-A port (sheet 2).
