waagbo/picogus-tht/hw-ne2k/PicoGUS-NE2K.kicad_pcb

## KiCad design hw-ne2k/PicoGUS-NE2K.kicad_pcb (continued)

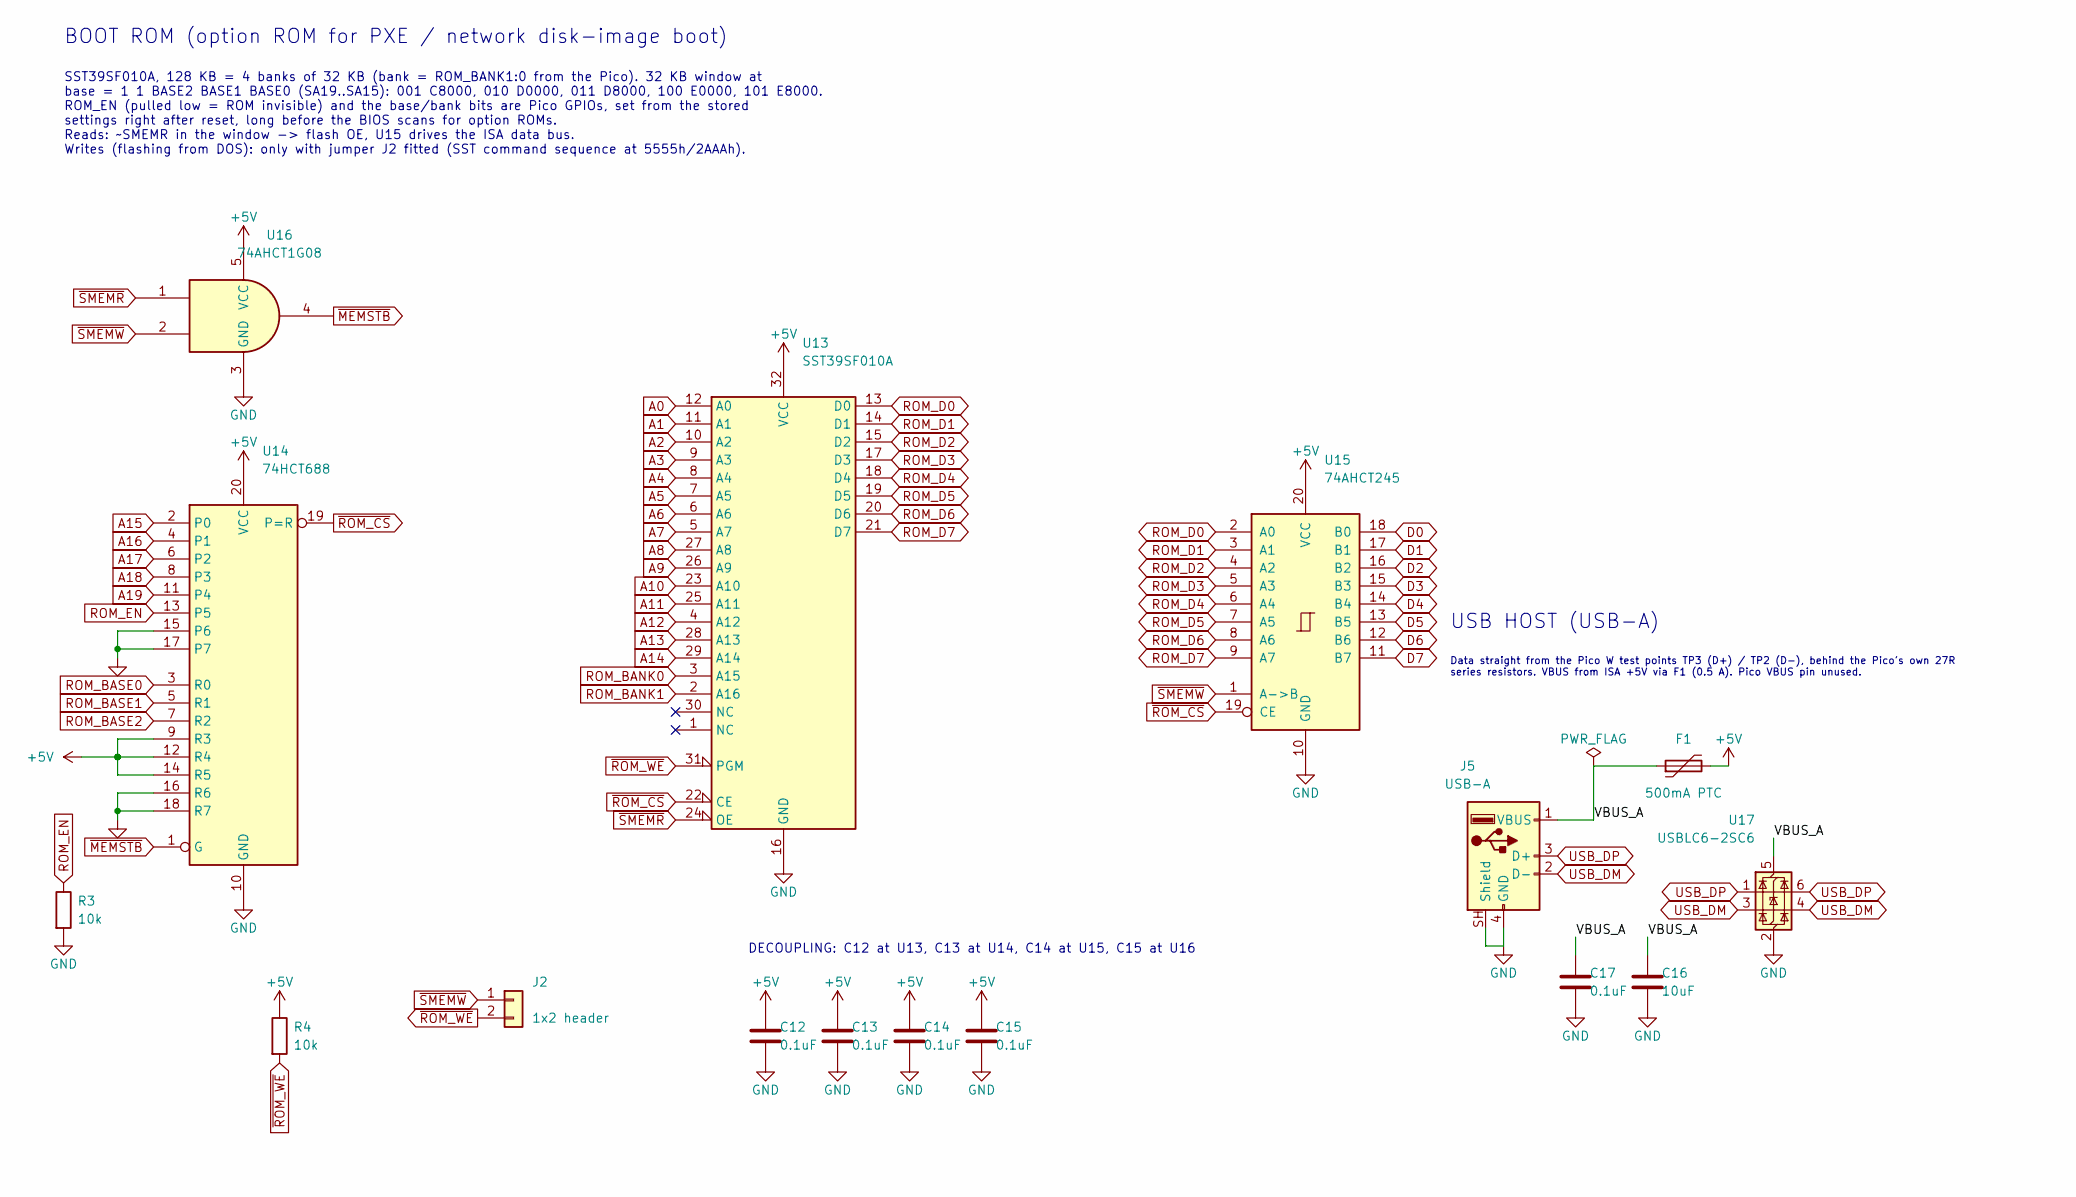
[picture p32: schematic bootrom.kicad_sch, PicoGUS NE2000 - boot ROM & USB host]

Parts:
C12, C13, C14, C15, C17: 0.1uF; C_0805_2012Metric; MPN CL21B104KBCNNNC; DigiKey 1276-1003-1-ND
C16: 10uF; C_1206_3216Metric; MPN CL31A106KAHNNNE; DigiKey 1276-1075-1-ND
F1: 500mA PTC; Fuse_1206_3216Metric; MPN MF-NSMF050-2; DigiKey MF-NSMF050-2CT-ND
J2: 1x2 header; PinHeader_1x02_P2.54mm_Vertical; MPN 77311-118-02LF; DigiKey 609-4434-ND
J5: USB-A; USB_A_Molex_67643_Horizontal; MPN 0676432910; DigiKey WM11258-ND
R3, R4: 10k; R_0805_2012Metric; MPN RC0805FR-0710KL; DigiKey 311-10.0KCRCT-ND
U13: SST39SF010A; PLCC-32_11.4x14.0mm_P1.27mm; MPN SST39SF010A-70-4C-NHE; DigiKey SST39SF010A-70-4C-NHE-ND
U14: 74HCT688; SOIC-20W_7.5x12.8mm_P1.27mm; MPN CD74HCT688M96; DigiKey 296-24357-1-ND
U15: 74AHCT245; TSSOP-20_4.4x6.5mm_P0.65mm; MPN SN74AHCT245PWR; DigiKey 296-1118-1-ND
U16: 74AHCT1G08; SOT-23-5; MPN SN74AHCT1G08DBVR; DigiKey 296-1113-1-ND
U17: USBLC6-2SC6; SOT-23-6; MPN USBLC6-2SC6; DigiKey 497-5235-1-ND

Connections:
+5V: C12.1, C13.1, C14.1, C15.1, F1.2, R4.1, U13.32 (VCC), U14.9 (R3), U14.12 (R4), U14.14 (R5), U14.20 (VCC), U15.20 (VCC), U16.5 (VCC); also elsewhere on the board
/Boot ROM & USB/VBUS_A: C16.1, C17.1, F1.1, J5.1 (VBUS), U17.5 (VBUS)
A0: U13.12 (A0); also elsewhere on the board
A1: U13.11 (A1); also elsewhere on the board
A2: U13.10 (A2); also elsewhere on the board
A3: U13.9 (A3); also elsewhere on the board
A4: U13.8 (A4); also elsewhere on the board
A5: U13.7 (A5); also elsewhere on the board
A6: U13.6 (A6); also elsewhere on the board
A7: U13.5 (A7); also elsewhere on the board
A8: U13.27 (A8); also elsewhere on the board
A9: U13.26 (A9); also elsewhere on the board
A10: U13.23 (A10); also elsewhere on the board
A11: U13.25 (A11); also elsewhere on the board
A12: U13.4 (A12); also elsewhere on the board
A13: U13.28 (A13); also elsewhere on the board
A14: U13.29 (A14); also elsewhere on the board
A15: U14.2 (P0); also elsewhere on the board
A16: U14.4 (P1); also elsewhere on the board
A17: U14.6 (P2); also elsewhere on the board
A18: U14.8 (P3); also elsewhere on the board
A19: U14.11 (P4); also elsewhere on the board
D0: U15.18 (B0); also elsewhere on the board
D1: U15.17 (B1); also elsewhere on the board
D2: U15.16 (B2); also elsewhere on the board
D3: U15.15 (B3); also elsewhere on the board
D4: U15.14 (B4); also elsewhere on the board
D5: U15.13 (B5); also elsewhere on the board
D6: U15.12 (B6); also elsewhere on the board
D7: U15.11 (B7); also elsewhere on the board
GND: C12.2, C13.2, C14.2, C15.2, C16.2, C17.2, J5.4 (GND), J5.SH (Shield), R3.2, U13.16 (GND), U14.10 (GND), U14.15 (P6), U14.16 (R6), U14.17 (P7), U14.18 (R7), U15.10 (GND), U16.3 (GND), U17.2 (GND); also elsewhere on the board
ROM_BANK0: U13.3 (A15); also elsewhere on the board
ROM_BANK1: U13.2 (A16); also elsewhere on the board
ROM_BASE0: U14.3 (R0); also elsewhere on the board
ROM_BASE1: U14.5 (R1); also elsewhere on the board
ROM_BASE2: U14.7 (R2); also elsewhere on the board
ROM_D0: U13.13 (D0), U15.2 (A0)
ROM_D1: U13.14 (D1), U15.3 (A1)
ROM_D2: U13.15 (D2), U15.4 (A2)
ROM_D3: U13.17 (D3), U15.5 (A3)
ROM_D4: U13.18 (D4), U15.6 (A4)
ROM_D5: U13.19 (D5), U15.7 (A5)
ROM_D6: U13.20 (D6), U15.8 (A6)
ROM_D7: U13.21 (D7), U15.9 (A7)
ROM_EN: R3.1, U14.13 (P5); also elsewhere on the board
USB_DM: J5.2 (D-), U17.3 (I/O2), U17.4 (I/O2); also elsewhere on the board
USB_DP: J5.3 (D+), U17.1 (I/O1), U17.6 (I/O1); also elsewhere on the board
~MEMSTB: U14.1 (G), U16.4
~ROM_CS: U13.22 (CE), U14.19 (P=R), U15.19 (CE)
~ROM_WE: J2.2, R4.2, U13.31 (PGM)
~SMEMR: U13.24 (OE), U16.1; also elsewhere on the board
~SMEMW: J2.1, U15.1 (A->B), U16.2; also elsewhere on the board

Notes on the sheet:
DECOUPLING: C12 at U13, C13 at U14, C14 at U15, C15 at U16
BOOT ROM (option ROM for PXE / network disk-image boot)
SST39SF010A, 128 KB = 4 banks of 32 KB (bank = ROM_BANK1:0 from the Pico). 32 KB window at base = 1 1 BASE2 BASE1 BASE0 (SA19..SA15): 001 C8000, 010 D0000, 011 D8000, 100 E0000, 101 E8000. ROM_EN (pulled low = ROM invisible) and the base/bank bits are Pico GPIOs, set from the stored settings right 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
USB HOST (USB-A)
Data straight from the Pico W test points TP3 (D+) / TP2 (D-), behind the Pico's own 27R series resistors. VBUS from ISA +5V via F1 (0.5 A). Pico VBUS pin unused.

Board: 2 copper layers, 46 parts (0 on the bottom side), 94 nets, no tracks yet.
