waagbo/picogus-tht/(commit log)

2026-11-07 PicoGUS THT v1.3.2 board
    * hw-tht: WIP through-hole PicoGUS v1.2 variant with Waveblaster header
    Work in progress: schematic, BOM, README, hybrid DIP/TSSOP footprints and
    placed (not yet routed) PCB for a through-hole version of PicoGUS v1.2.
    - KiCad 10 project copied from hw/ (v1.2) with THT parts where they exist;
    the CB3T3257 muxes, PSRAM and PCM510x DAC stay SMD.
    - DIP-14/DIP-20 footprints also take the TSSOP version (inside or beside it).
    - New Waveblaster header with 3.3 V-safe MIDI and /RESET, WT volume (dual
    log pot) and a NE5532 inverting mixer powered from ISA +/-12 V.
    - BOM with DigiKey and LCSC part numbers and stock as of 2026-09-28.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
    [BOM-NE2K-digikey-upload-10x.csv, BOM-NE2K-digikey-upload.csv, BOM-NE2K.csv, BOM-SMD-digikey-upload-10x.csv, BOM-SMD-digikey-upload.csv, BOM-SMD.csv, BOM-THT-digikey-optional.csv, BOM-THT-digikey.csv]
2026-11-11 JLCPCB export: full assembly BOM and placement, clean LCSC numbers
    - jlcpcb.sh: the assembly BOM keeps every part and takes the bare LCSC
    number from each LCSC field ("C3690252 (RCER71H106MWM1H03A)" gives
    C3690252, with the note's part as MPN), so JLCPCB's tool can read
    every line. CPL=all puts the through-hole parts in the placement file
    as well, so JLCPCB can solder them; <board>-jlcpcb-parts.csv overrides
    single parts for assembly.
    - THT v1.3: PicoGUS-THT-jlcpcb-parts.csv gives J6/J7 a 1x2 header
    (Amphenol 77311-118-02LF, C599036) instead of the 1x40 strip the hand
    build cuts them from. RV1's LCSC field names the Alps part it is
    (both symbol units). Export: 39 BOM lines, 8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
    [PicoGUS-THT-jlcpcb-parts.csv, wavetable.kicad_sch]
2026-11-11 THT v1.3 BOM: gold pin headers for J1 and J6/J7
    - J6/J7: 2x Amphenol 77311-118-02LF (30 uin gold; DK 609-4434-ND,
    LCSC C599036) instead of the tin Sullins PREC040SAAN-RC 1x40 strip cut
    into 1x2s, which stays as the alternative. The same part is now in the
    DigiKey, LCSC and JLCPCB BOMs, so the JLCPCB override file is gone.
    - J1: Amphenol 77313-118-18LF (30 uin gold, same pin lengths; DK
    609-77313-118-18LF-ND) instead of the 10129381-918001BLF, which
    DigiKey lists with 1 uin gold. LCSC keeps the XFCN PZ254V-12-18P (the
    77313-118-18LF, C3327100, had no LCSC stock).
    - Schematic fields, BOM, upload files, schematic PDF and README follow;
    the socket BOM's note for Pico pins names the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
    [BOM-THT-digikey.csv, BOM-THT-lcsc.csv, BOM-THT-sockets.csv, BOM-THT.csv, PicoGUS-THT-jlcpcb-parts.csv, PicoGUS-THT.kicad_sch]
2026-11-11 THT v1.3 BOM: RV1 with a 15 mm flat shaft on both lines
    - DigiKey line: Bourns PTD902-2015F-A103 (15 mm flat shaft, 27.42 kr)
    instead of the PTD902-2020K-A103 (20 mm knurled).
    - LCSC/JLCPCB line: Alps RK09712200MC (C444934, 15 mm flat) instead of
    the RK09712200HA (20 mm flat). Both lines now take the same knob;
    DigiKey does not sell the RK09712200MC.
    - Schematic fields (both RV1 units), BOM, upload files, schematic PDF,
    README (RV1 notes, cost ~563 kr) and docs/lessons-learned.md follow.
    ERC 0 errors / 280 warnings.
    Claude-Session: https://claude.ai/code/session_011utN3x8yYUNDvkpGCEq5yD
    [BOM-THT-digikey.csv, BOM-THT-lcsc.csv, BOM-THT.csv, wavetable.kicad_sch]
2026-11-11 THT v1.3.2: put the optional U12 in the main DigiKey BOM
    U12 (USBLC6-2SC6) moves from BOM-THT-digikey-optional.csv to
    BOM-THT-digikey.csv, with the Customer Reference
    "PicoGUS-THT-1.3.2: U12 (optional)", so it comes with the DigiKey
    order. The LCSC files are unchanged (U12 stays in -optional).
    bom_uploads.py gets --digikey-main REFS for this; the README's file
    table, Ordering text and regenerate command follow.
    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
    [BOM-THT-digikey-optional.csv, BOM-THT-digikey.csv]
2026-11-11 THT v1.3.2: put the optional U12 in the main LCSC BOM as well
    U12 (USBLC6-2SC6, C7519) moves from BOM-THT-lcsc-optional.csv to
    BOM-THT-lcsc.csv with the Customer Part Number
    "PicoGUS-THT-1.3.2: U12 (optional)", as on the DigiKey side.
    bom_uploads.py: --digikey-main becomes --main and applies to both
    shops' files. The DigiKey files are unchanged; the README follows.
    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
    [BOM-THT-lcsc-optional.csv, BOM-THT-lcsc.csv]
2026-11-11 THT v1.3.2: Mouser and Farnell BOM upload files
    bom_uploads.py now also writes BOM-THT-mouser.csv and
    BOM-THT-farnell.csv (+ -optional, and the socket build's), for the
    shops' BOM tools: Quantity, Manufacturer Part Number, Manufacturer,
    Customer Part Number, Description. They carry no shop part numbers;
    the BOM tools match each line by manufacturer and MPN (the DigiKey
    line's).
    Mouser's Customer # takes 21 characters (CustomerPartNumber in its
    API), so the Mouser files have the positions without the board name,
    and the 20x 0.1uF line reads "0.1uF x20". Farnell gets the DigiKey
    text. The DigiKey and LCSC files are unchanged.
    Claude-Ses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
    [BOM-THT-farnell-optional.csv, BOM-THT-farnell.csv, BOM-THT-mouser-optional.csv, BOM-THT-mouser.csv, BOM-THT-sockets-farnell-optional.csv, BOM-THT-sockets-mouser-optional.csv]
2026-11-11 THT v1.3.2: U9 back to the PCM5100A (PCM5100APWR)
    The cheapest grade, as originally used: 24.69 kr at DigiKey on
    2026-11-11 against 59.83 kr for the PCM5102AQPWRQ1. With the
    firmware's 16-bit output the grades sound the same.
    - U9 (schematic and board fields): PCM5100A, MPN PCM5100APWR,
    DigiKey 296-36705-1-ND, LCSC C131154 (1167 in stock, in JLCPCB's
    extended library). The PCM5102A options move to Alternatives.
    - BOM-THT.csv (stock re-read: DigiKey 69, LCSC 1167), the DigiKey,
    LCSC, Mouser and Farnell upload files, the schematic PDF, the README
    (U9 notes, cost ~528 kr) and docs/lessons-learned.md follow.
    - ERC 0 errors; DRC 0 parity errors, the 12 accepted courtyard
    overlaps. Gerb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
    [BOM-THT-digikey.csv, BOM-THT-farnell.csv, BOM-THT-lcsc.csv, BOM-THT-mouser.csv, BOM-THT.csv, PicoGUS-THT.kicad_pcb, audio.kicad_sch]
2026-11-12 THT v1.3.2: DigiKey, LCSC and Mouser BOMs only, optional parts at the bottom
    - Farnell BOM removed: not complete enough to build a board.
    - BOM-THT-sockets.csv and its upload files removed: the optional socket
    lines of BOM-THT.csv cover the socket build; the README's Socket build
    section keeps the heights and the low-profile Adafruit Pico set.
    - No more -optional files: the optional parts (sockets, U12) are at the
    bottom of BOM-THT-digikey.csv, -lcsc.csv and -mouser.csv, each marked
    "(optional)" in its customer reference. The DIP-14 socket line, too
    long with it, is marked "(opt.)": "PicoGUS-THT-1.3.2: U5,U6,U7,U10
    sockets (opt.)" (48-character limit) and "U5,U6,U7,U10 (opt.)" on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
    [BOM-THT-digikey-optional.csv, BOM-THT-digikey.csv, BOM-THT-farnell-optional.csv, BOM-THT-farnell.csv, BOM-THT-lcsc-optional.csv, BOM-THT-lcsc.csv, BOM-THT-mouser-optional.csv, BOM-THT-mouser.csv]
2026-11-13 Mark USB-A Connector as completed in README
    Updated README to reflect USB-A Connector status.
