waagbo/picogus-tht/(notices)

Notices in the files:
hw-smd/PicoGUS-SMD.kicad_pcb:
© 2023-2026 Ian Scott (polpo), Vidar Waagbø (waagbo)
Licensed under CERN-OHL-P v2
